adibhudapratama/BARELANG/cargo_hold_v6/docs/interior.jpg

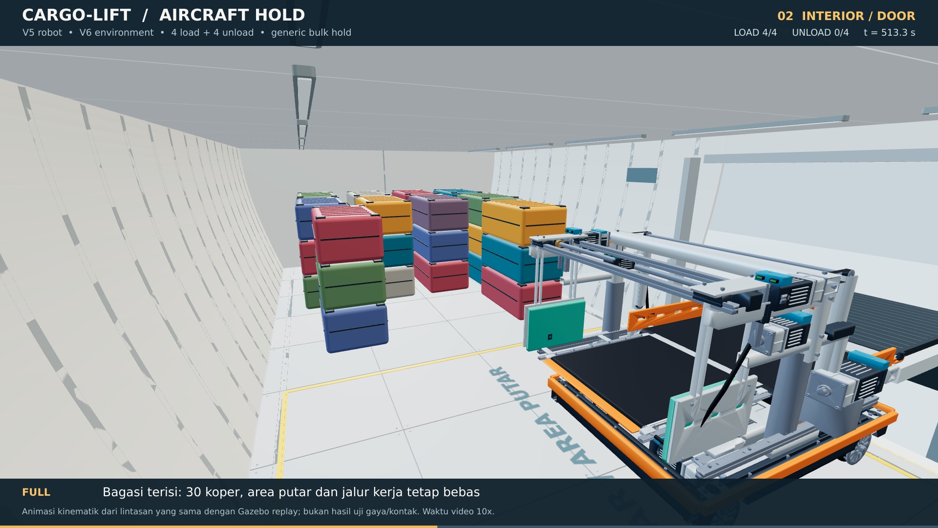
cargo_hold_v6/docs/interior.jpg
