adibhudapratama/BARELANG/cargo_hold_v6/docs/Storyboard_v6.jpg

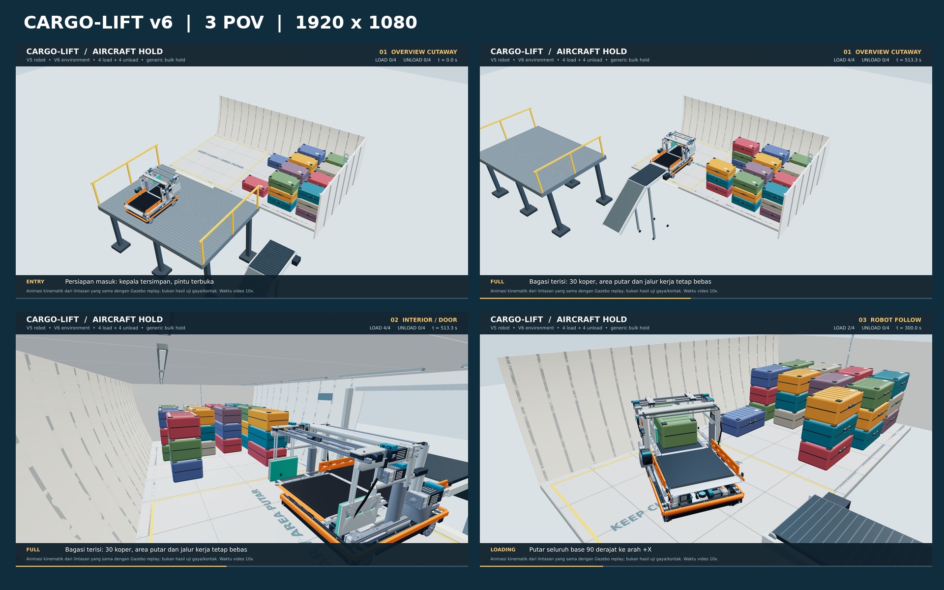
cargo_hold_v6/docs/Storyboard_v6.jpg
