adibhudapratama/BARELANG/cargo_hold_v6/docs/tracking.jpg

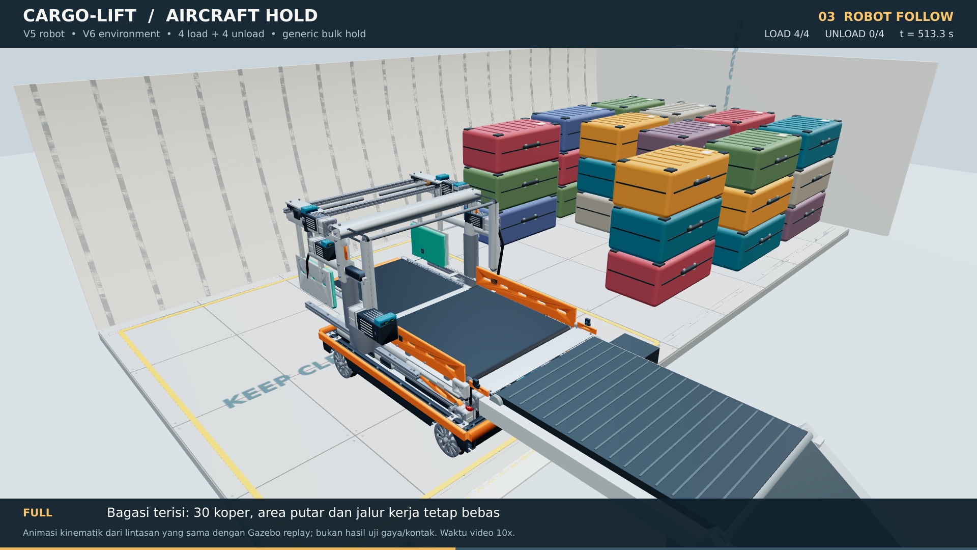
cargo_hold_v6/docs/tracking.jpg
