adibhudapratama/BARELANG/cargo_hold_v6/cad/Bagasi_Pesawat_Generic_Full.step

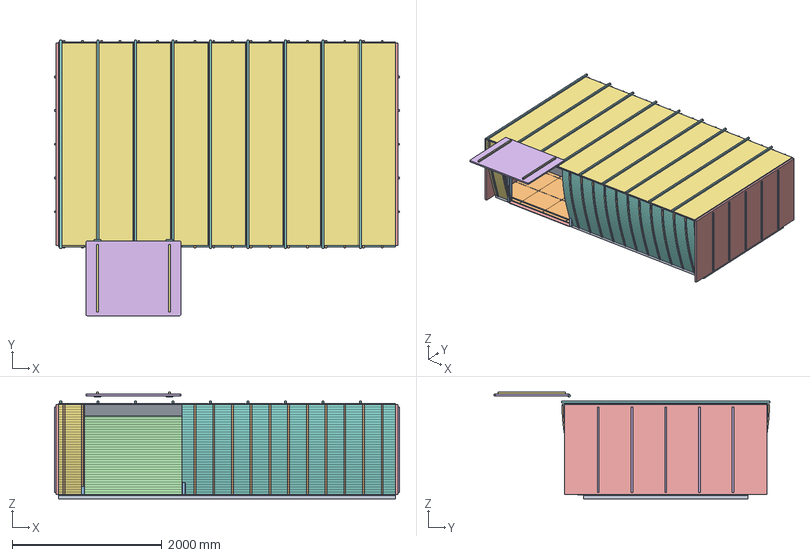
[picture p19: CAD file, 2026-10-20]
cargo_hold_v6/cad/Bagasi_Pesawat_Generic_Full.step
4606.0 x 3680.0 x 1424.5 mm
