adibhudapratama/BARELANG/cargo_hold_v6/models/cargo_robot/meshes/main_belt_roller_link__00.stl

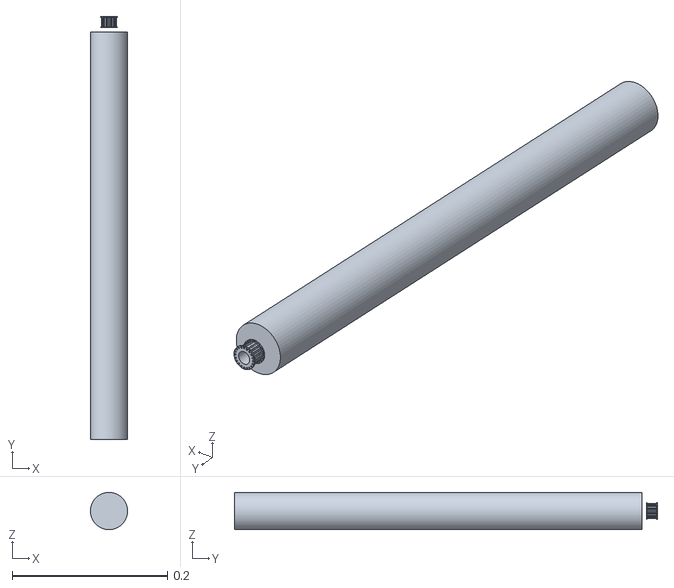
[picture p20: CAD file, 2026-10-20]
cargo_hold_v6/models/cargo_robot/meshes/main_belt_roller_link__00.stl
0.048 x 0.545 x 0.048
