adibhudapratama/BARELANG/cargo_hold_v6/models/cargo_robot/meshes/main_belt_roller_link.stl

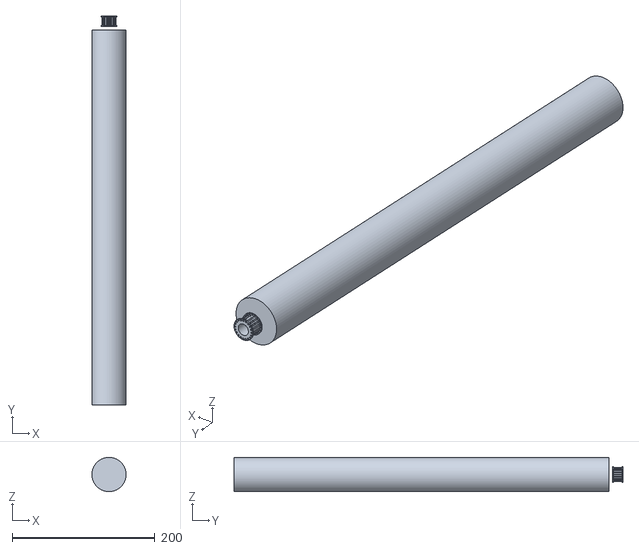
[picture p21: CAD file, 2026-10-20]
cargo_hold_v6/models/cargo_robot/meshes/main_belt_roller_link.stl
47.9 x 544.7 x 48.0
