adibhudapratama/BARELANG/cargo_hold_v6/models/aircraft_hold/meshes/door_1.stl

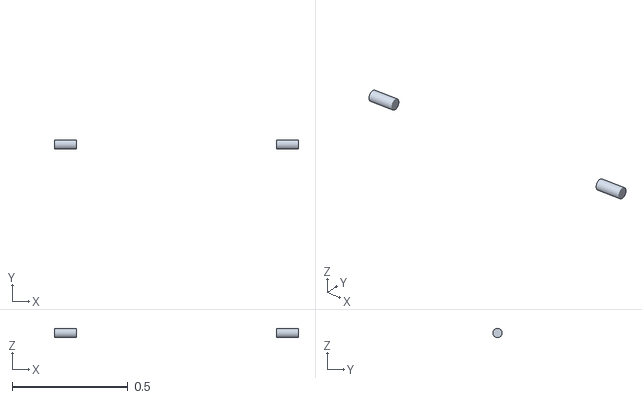
[picture p22: CAD file, 2026-10-20]
cargo_hold_v6/models/aircraft_hold/meshes/door_1.stl
1.06 x 0.04 x 0.04
