adibhudapratama/BARELANG/cargo_hold_v6/models/cargo_robot/meshes/rr_roller11_link__01.stl

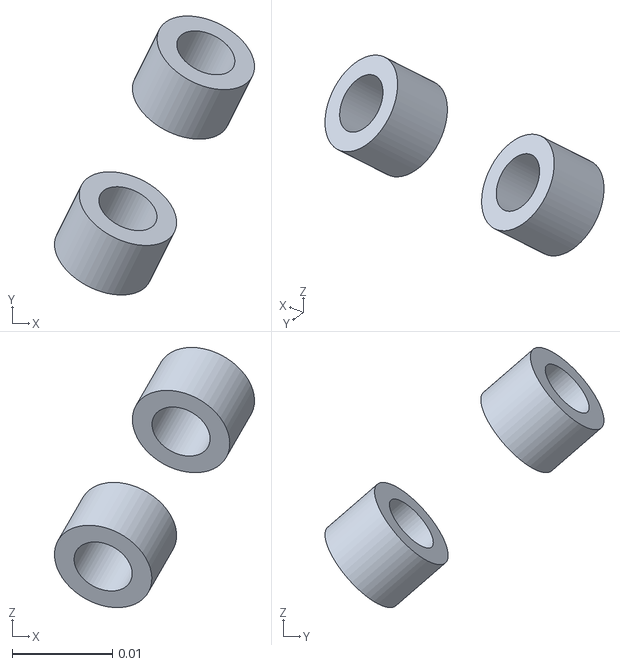
[picture p23: CAD file, 2026-10-20]
cargo_hold_v6/models/cargo_robot/meshes/rr_roller11_link__01.stl
0.02 x 0.0279 x 0.026
