adibhudapratama/BARELANG/cargo_hold_v6/models/luggage/meshes/trim.stl

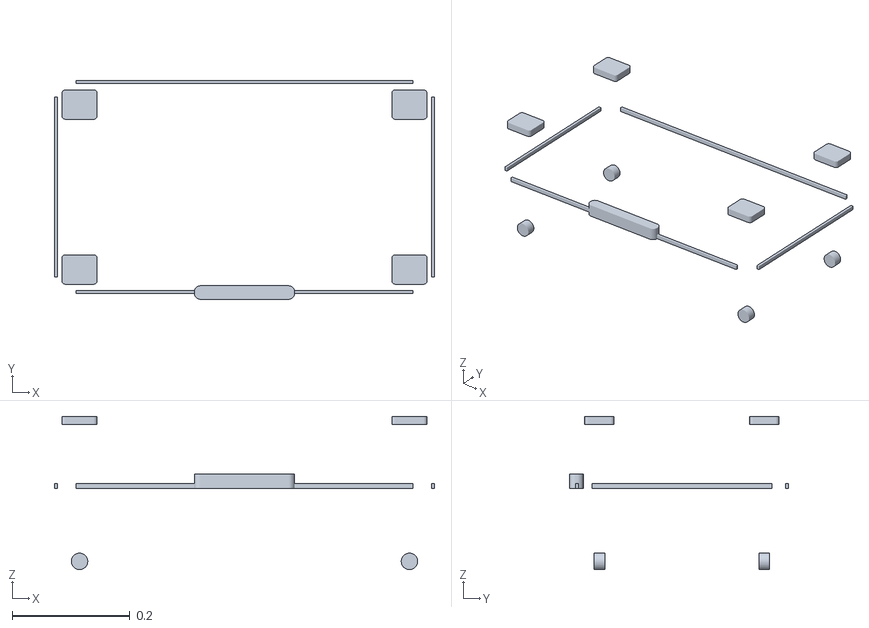
[picture p24: CAD file, 2026-10-20]
cargo_hold_v6/models/luggage/meshes/trim.stl
0.645 x 0.371 x 0.26
