adibhudapratama/BARELANG/cargo_hold_v6/ros2_ws/src/cargo_robot_description/models/cargo_robot/meshes/fr_roller02_link__00.stl

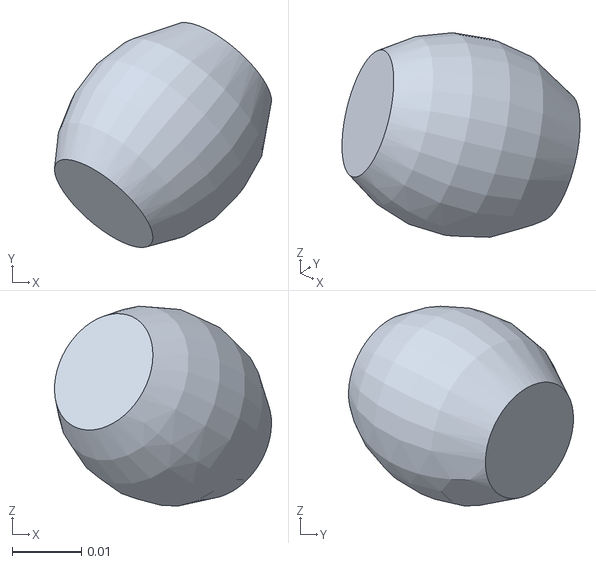
[picture p25: CAD file, 2026-10-20]
cargo_hold_v6/ros2_ws/src/cargo_robot_description/models/cargo_robot/meshes/fr_roller02_link__00.stl
0.0314 x 0.0325 x 0.0289
