adibhudapratama/BARELANG/cargo_hold_v6/cad/Bagasi_Pesawat_Generic_Cutaway.step

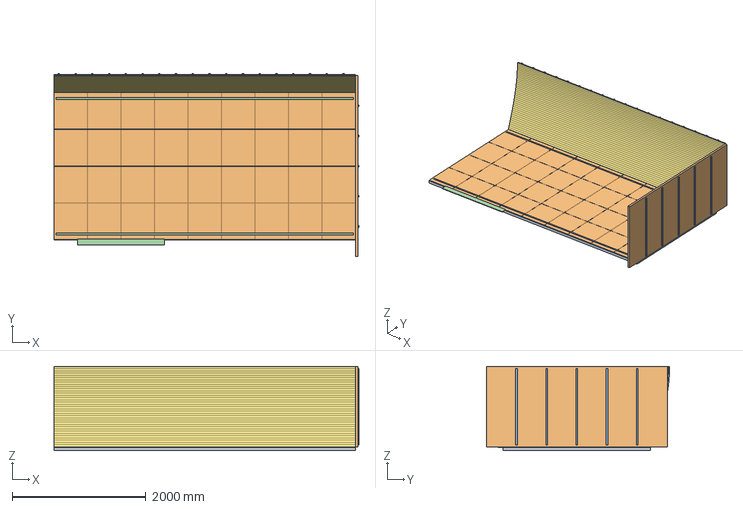
[picture p26: CAD file, 2026-10-20]
cargo_hold_v6/cad/Bagasi_Pesawat_Generic_Cutaway.step
4553.0 x 2735.0 x 1257.0 mm
