adibhudapratama/BARELANG/cargo_hold_v6/models/aircraft_hold/meshes/near_wall_0.stl

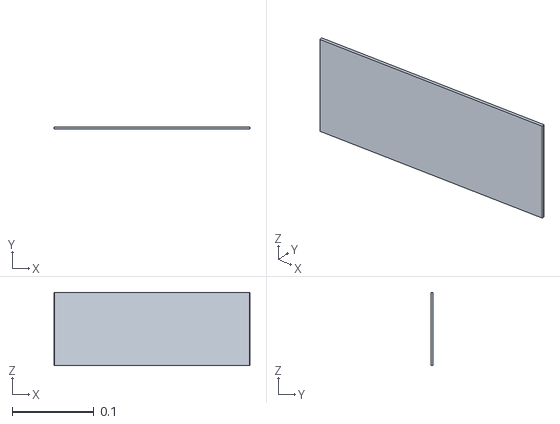
[picture p27: CAD file, 2026-10-20]
cargo_hold_v6/models/aircraft_hold/meshes/near_wall_0.stl
0.24 x 0.003 x 0.09
