adibhudapratama/BARELANG/cargo_hold_v6/models/cargo_robot/meshes/fl_roller10_link__02.stl

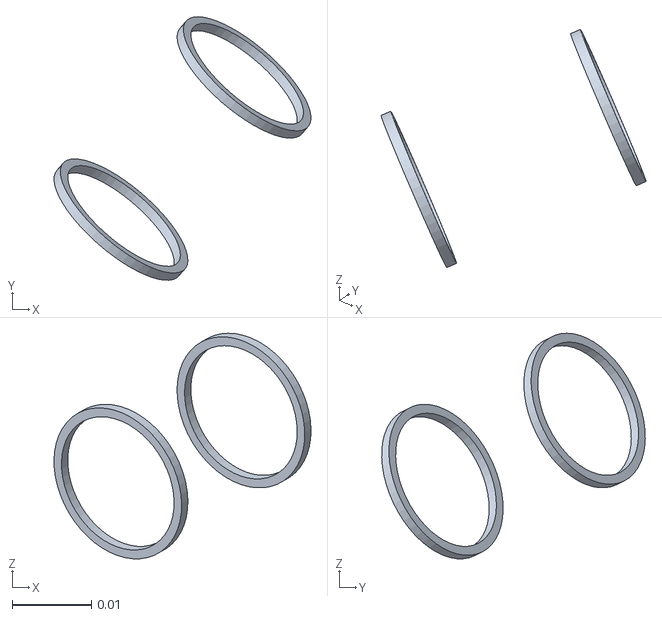
[picture p28: CAD file, 2026-10-20]
cargo_hold_v6/models/cargo_robot/meshes/fl_roller10_link__02.stl
0.0325 x 0.0333 x 0.0285
