adibhudapratama/BARELANG/cargo_hold_v6/models/luggage/meshes/shell.stl

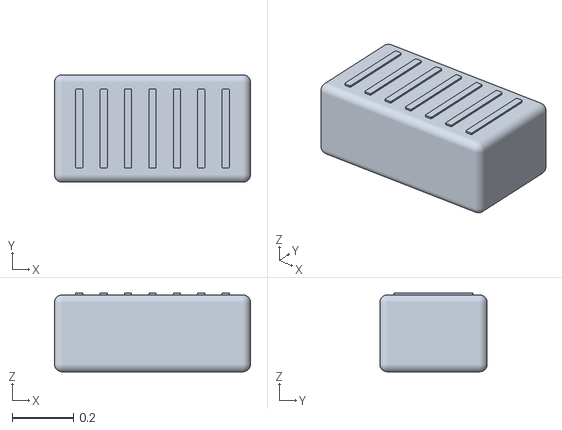
[picture p29: CAD file, 2026-10-20]
cargo_hold_v6/models/luggage/meshes/shell.stl
0.642 x 0.352 x 0.258
