adibhudapratama/BARELANG/cargo_hold_v6/models/aircraft_hold/meshes/near_wall_4.stl

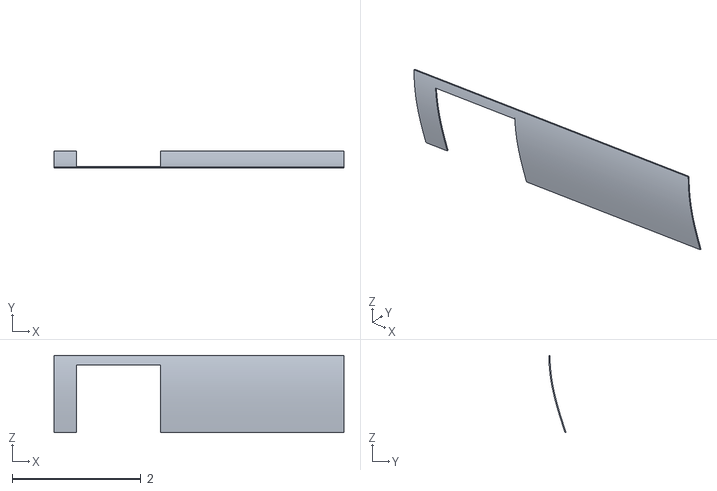
[picture p30: CAD file, 2026-10-20]
cargo_hold_v6/models/aircraft_hold/meshes/near_wall_4.stl
4.50 x 0.268 x 1.20
