adibhudapratama/BARELANG/cargo_hold_v6/ros2_ws/src/cargo_robot_description/models/cargo_robot/meshes/rr_roller06_link__02.stl

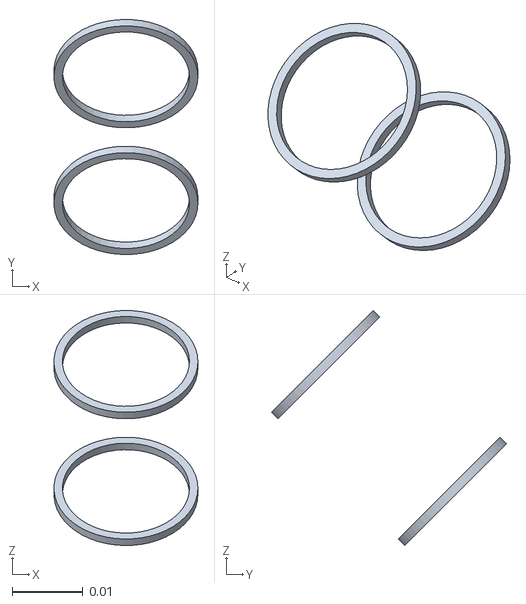
[picture p31: CAD file, 2026-10-20]
cargo_hold_v6/ros2_ws/src/cargo_robot_description/models/cargo_robot/meshes/rr_roller06_link__02.stl
0.0204 x 0.0333 x 0.0333
