adibhudapratama/BARELANG/cad/Cargo_Lift_Robot.step

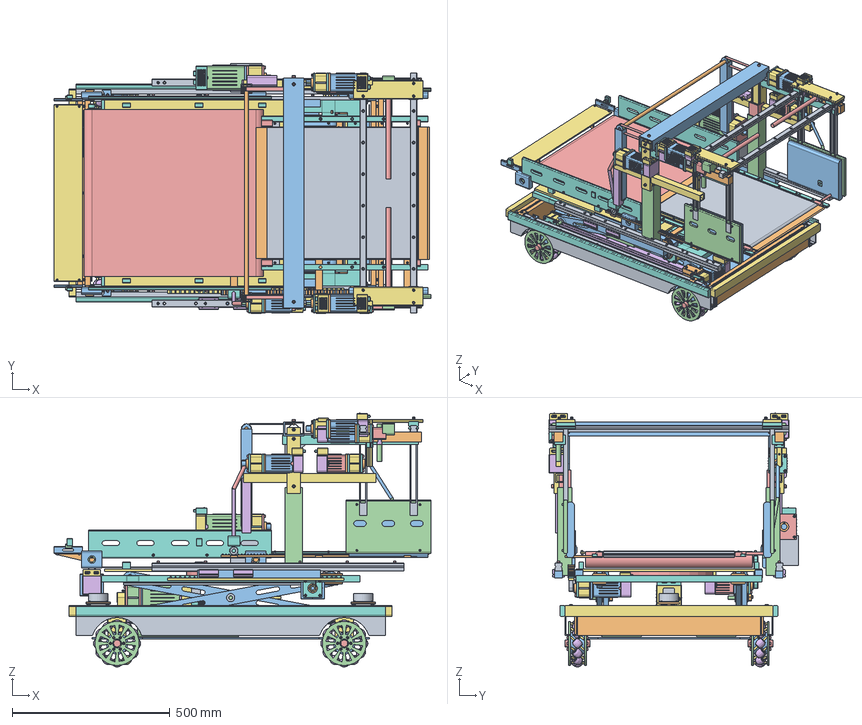
[picture p32: CAD file, 2026-10-20]
cad/Cargo_Lift_Robot.step
1195.0 x 791.0 x 804.4 mm
