adibhudapratama/BARELANG/cargo_hold_v6/models/aircraft_hold/meshes/floor_6.stl

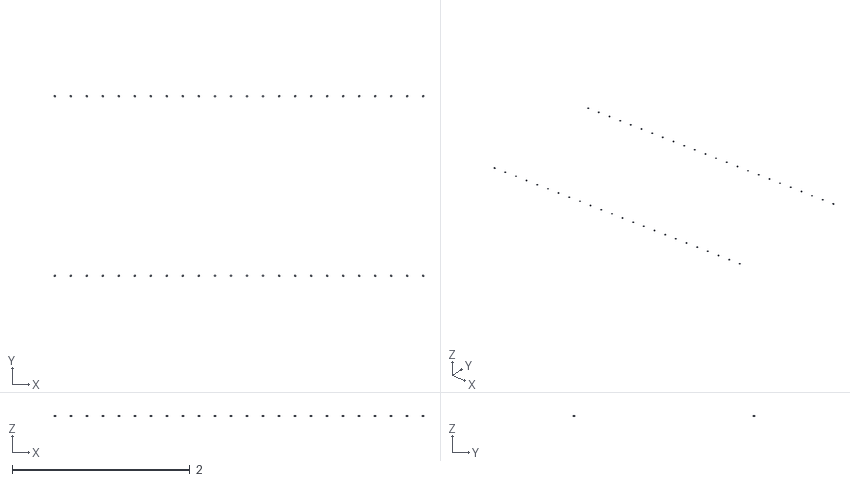
[picture p33: CAD file, 2026-10-20]
cargo_hold_v6/models/aircraft_hold/meshes/floor_6.stl
4.16 x 2.04 x 0.002
