adibhudapratama/BARELANG/cargo_hold_v6/models/cargo_robot/meshes/lift_carrier_link__01.stl

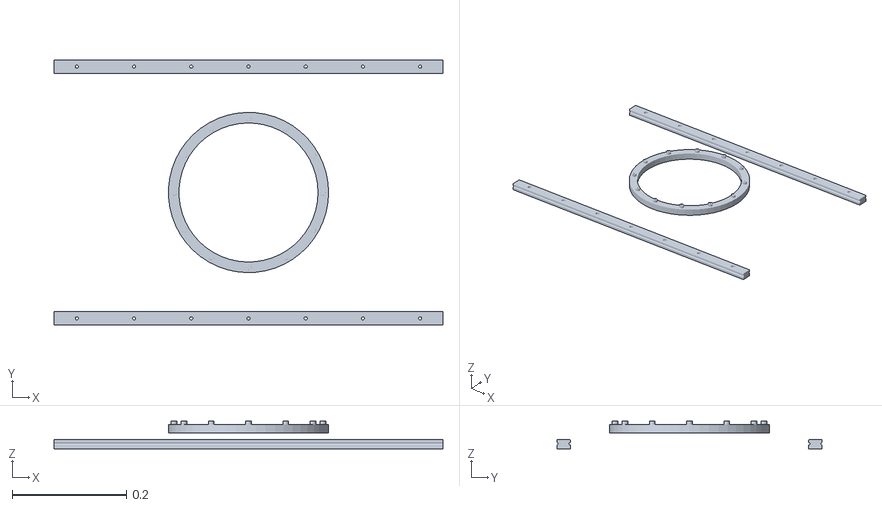
[picture p34: CAD file, 2026-10-20]
cargo_hold_v6/models/cargo_robot/meshes/lift_carrier_link__01.stl
0.68 x 0.464 x 0.0485
