adibhudapratama/BARELANG/cargo_hold_v6/ros2_ws/src/cargo_robot_description/models/cargo_robot/meshes/support_blade_link__01.stl

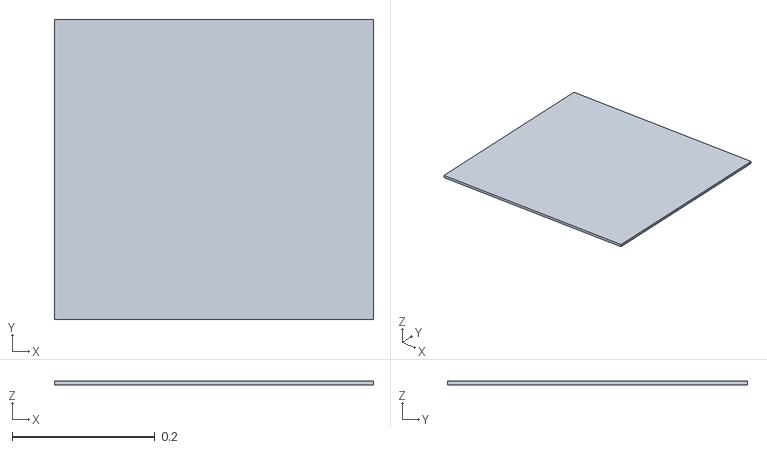
[picture p35: CAD file, 2026-10-20]
cargo_hold_v6/ros2_ws/src/cargo_robot_description/models/cargo_robot/meshes/support_blade_link__01.stl
0.447 x 0.42 x 0.005
