adibhudapratama/BARELANG/cargo_hold_v6/models/aircraft_hold/meshes/door_0.stl

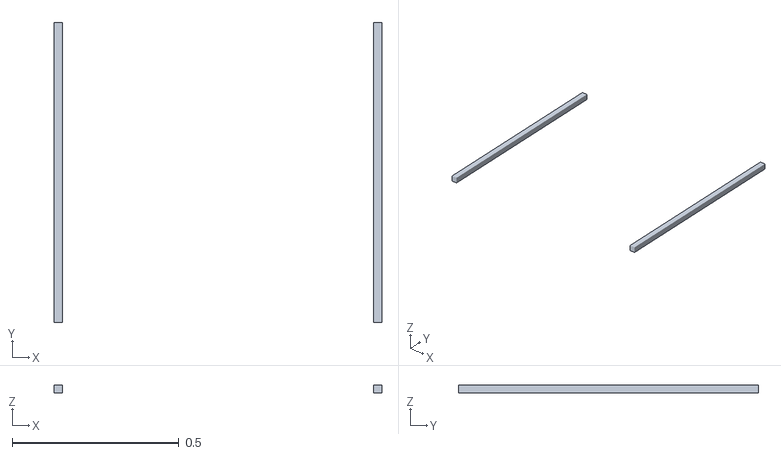
[picture p37: CAD file, 2026-10-20]
cargo_hold_v6/models/aircraft_hold/meshes/door_0.stl
0.985 x 0.9 x 0.025
