adibhudapratama/BARELANG/cargo_hold_v6/models/cargo_robot/meshes/fr_roller06_link__00.stl

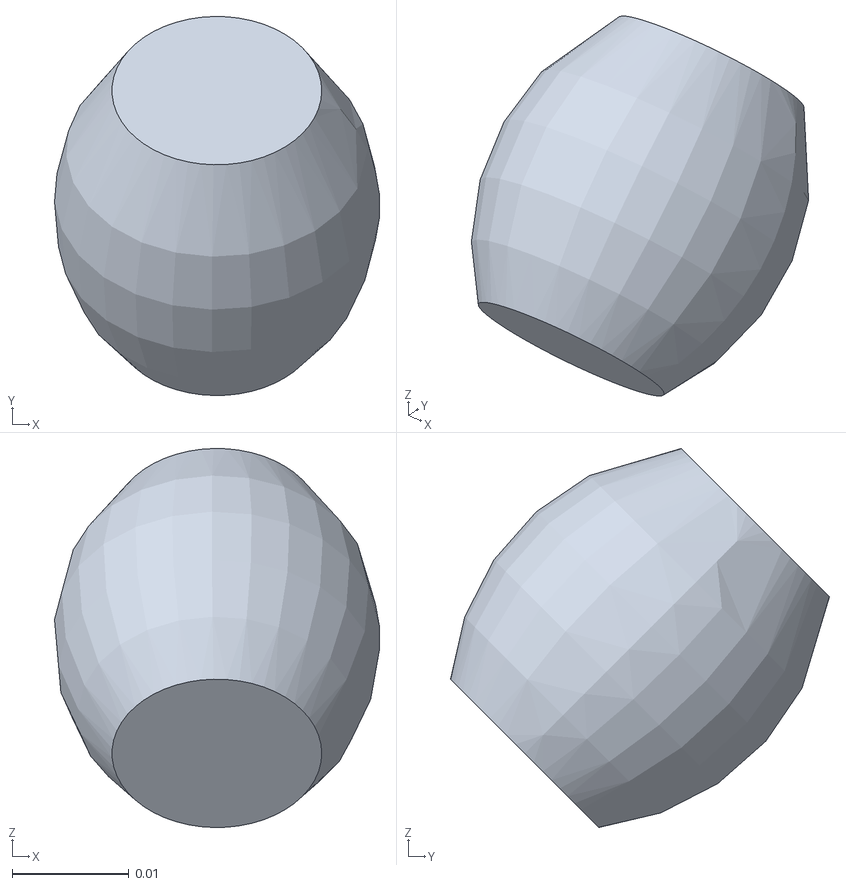
[picture p38: CAD file, 2026-10-20]
cargo_hold_v6/models/cargo_robot/meshes/fr_roller06_link__00.stl
0.0279 x 0.0325 x 0.0325
