adibhudapratama/BARELANG/cargo_hold_v6/models/aircraft_hold/meshes/roof_2.stl

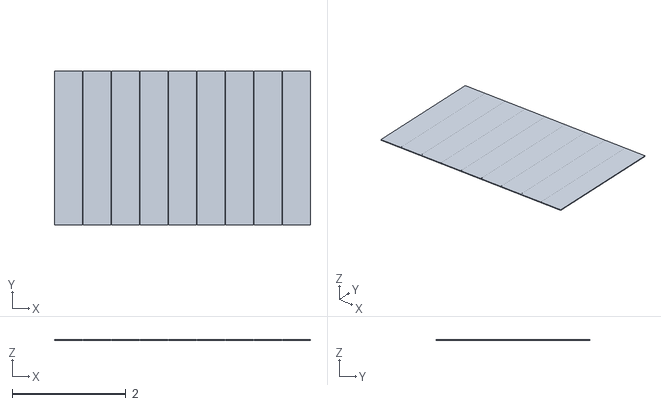
[picture p39: CAD file, 2026-10-20]
cargo_hold_v6/models/aircraft_hold/meshes/roof_2.stl
4.50 x 2.70 x 0.014
