adibhudapratama/BARELANG/cargo_hold_v6/models/cargo_robot/meshes/extension_link.stl

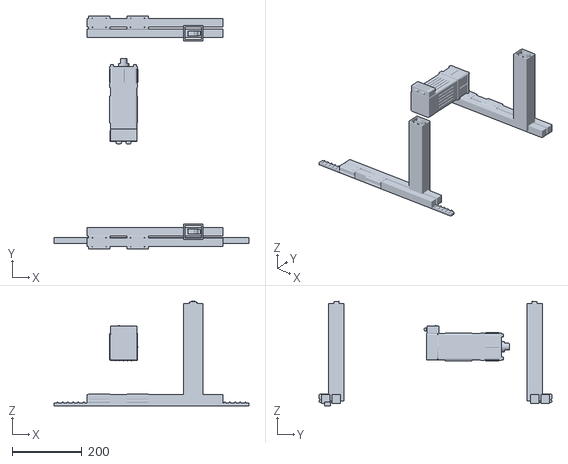
[picture p40: CAD file, 2026-10-20]
cargo_hold_v6/models/cargo_robot/meshes/extension_link.stl
560.0 x 668.0 x 301.5
