adibhudapratama/BARELANG/cargo_hold_v6/models/aircraft_hold/meshes/roof_0.stl

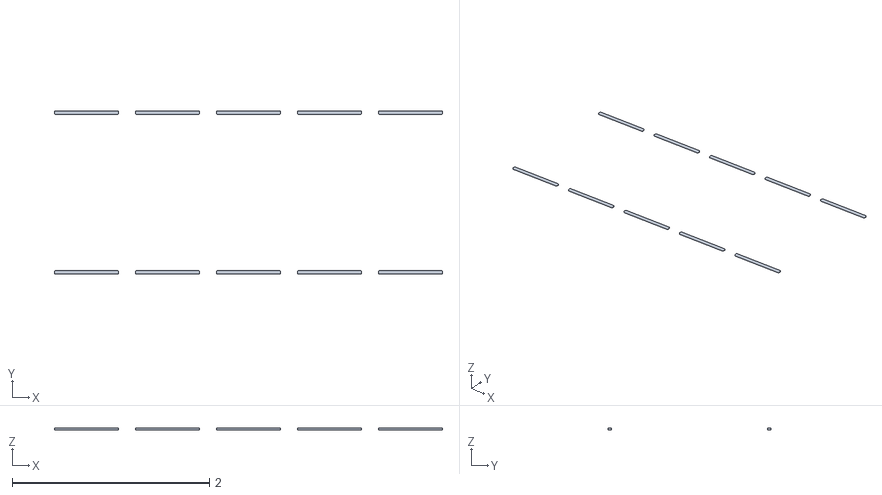
[picture p41: CAD file, 2026-10-20]
cargo_hold_v6/models/aircraft_hold/meshes/roof_0.stl
3.93 x 1.66 x 0.016
