adibhudapratama/BARELANG/cargo_hold_v6/models/cargo_robot/meshes/rl_roller01_link.stl

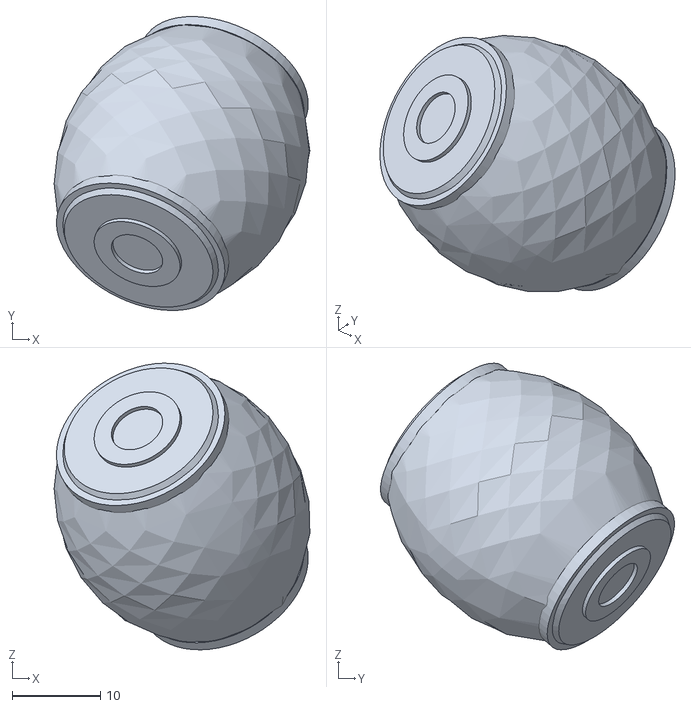
[picture p42: CAD file, 2026-10-20]
cargo_hold_v6/models/cargo_robot/meshes/rl_roller01_link.stl
29.0 x 33.3 x 32.5
