adibhudapratama/BARELANG/cargo_hold_v6/ros2_ws/src/cargo_robot_description/models/cargo_robot/meshes/fl_roller00_link__01.stl

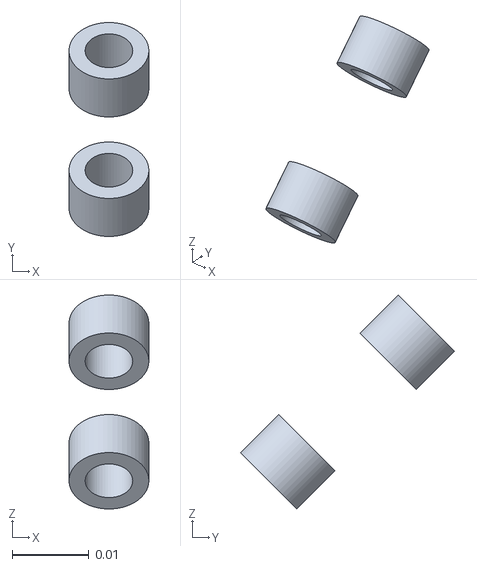
[picture p43: CAD file, 2026-10-20]
cargo_hold_v6/ros2_ws/src/cargo_robot_description/models/cargo_robot/meshes/fl_roller00_link__01.stl
0.0104 x 0.0279 x 0.0279
