adibhudapratama/BARELANG/cargo_hold_v6/models/aircraft_hold/meshes/floor_7.stl

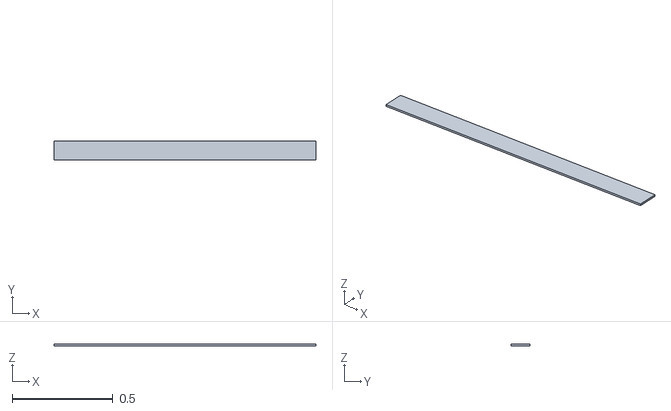
[picture p44: CAD file, 2026-10-20]
cargo_hold_v6/models/aircraft_hold/meshes/floor_7.stl
1.30 x 0.095 x 0.008
