adibhudapratama/BARELANG/cargo_hold_v6/models/cargo_robot/meshes/conveyor_yaw_link__07.stl

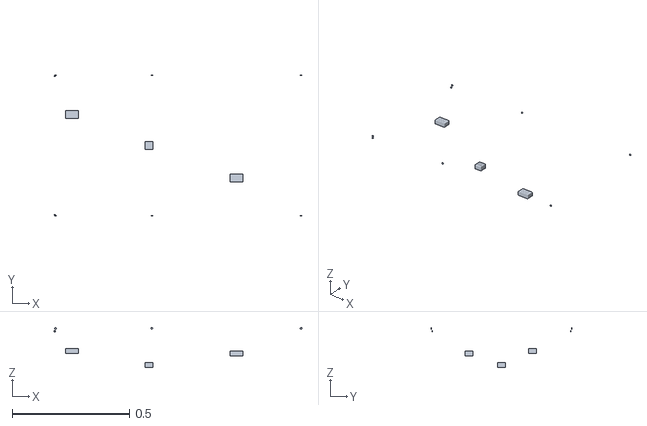
[picture p45: CAD file, 2026-10-20]
cargo_hold_v6/models/cargo_robot/meshes/conveyor_yaw_link__07.stl
1.06 x 0.599 x 0.171
