adibhudapratama/BARELANG/cargo_hold_v6/models/aircraft_hold/meshes/front_wall_0.stl

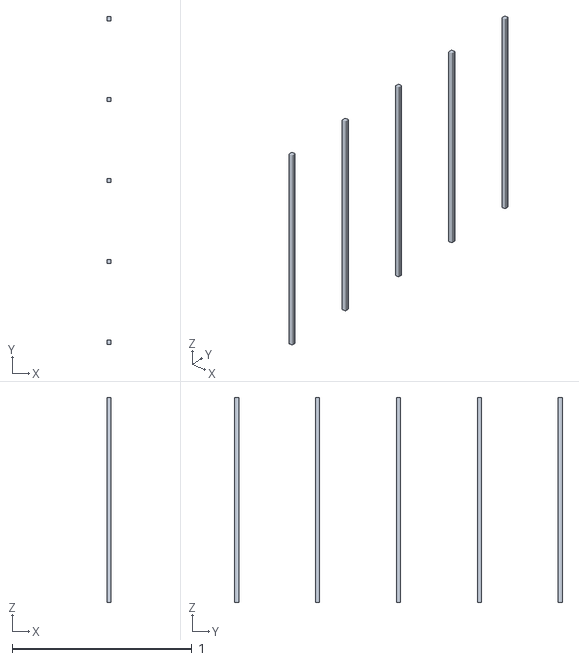
[picture p46: CAD file, 2026-10-20]
cargo_hold_v6/models/aircraft_hold/meshes/front_wall_0.stl
0.022 x 1.82 x 1.14
