adibhudapratama/BARELANG/cargo_hold_v6/ros2_ws/src/cargo_robot_description/models/cargo_robot/meshes/conveyor_yaw_link__00.stl

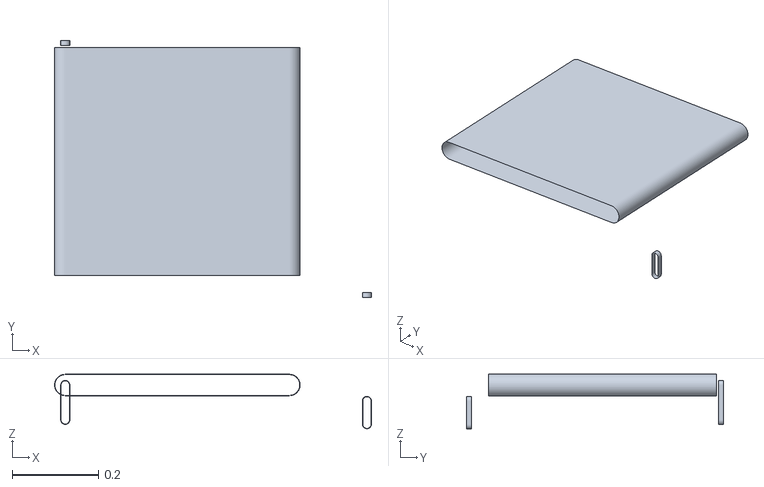
[picture p47: CAD file, 2026-10-20]
cargo_hold_v6/ros2_ws/src/cargo_robot_description/models/cargo_robot/meshes/conveyor_yaw_link__00.stl
0.736 x 0.597 x 0.127
