adibhudapratama/BARELANG/cargo_hold_v6/models/cargo_robot/meshes/pickup_head_link__05.stl

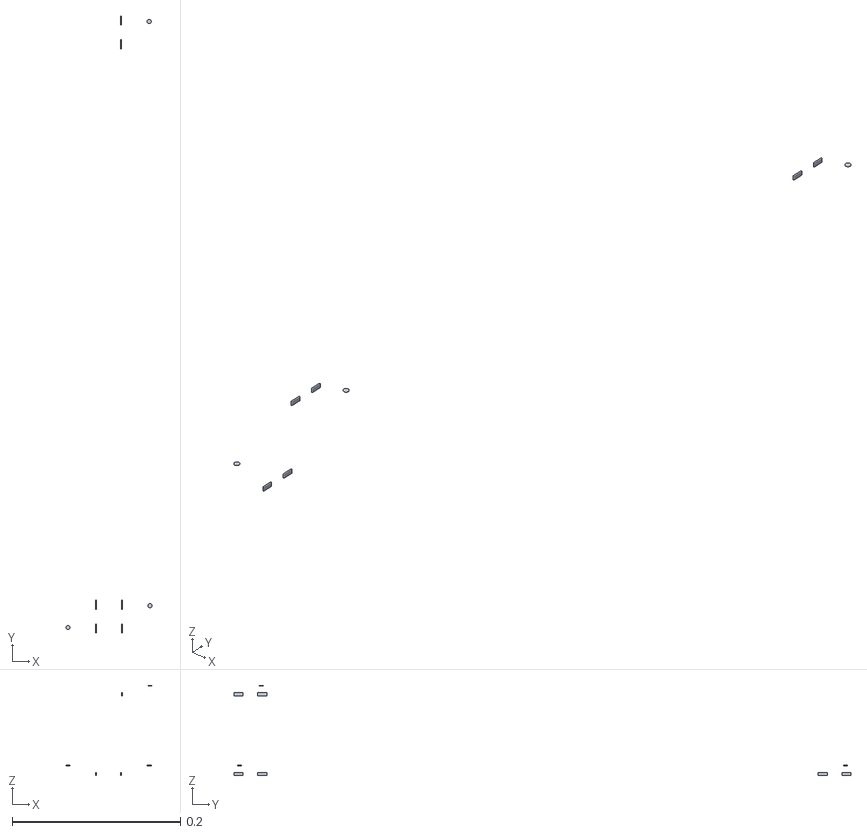
[picture p49: CAD file, 2026-10-20]
cargo_hold_v6/models/cargo_robot/meshes/pickup_head_link__05.stl
0.103 x 0.734 x 0.108
