adibhudapratama/BARELANG/cargo_hold_v6/models/aircraft_hold/meshes/floor_3.stl

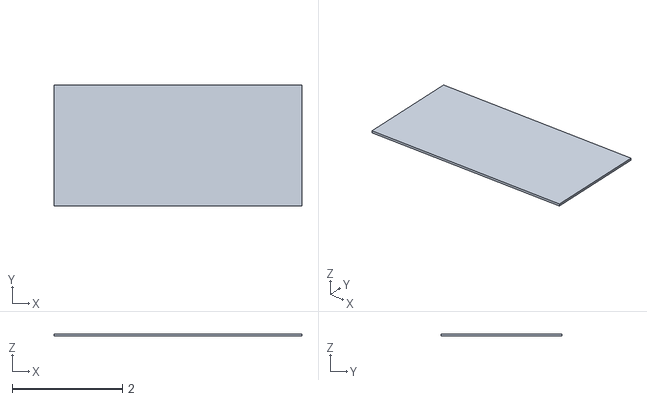
[picture p50: CAD file, 2026-10-20]
cargo_hold_v6/models/aircraft_hold/meshes/floor_3.stl
4.50 x 2.20 x 0.045
