adibhudapratama/BARELANG/cargo_hold_v6/ros2_ws/src/cargo_robot_description/models/cargo_robot/meshes/fl_wheel_link__00.stl

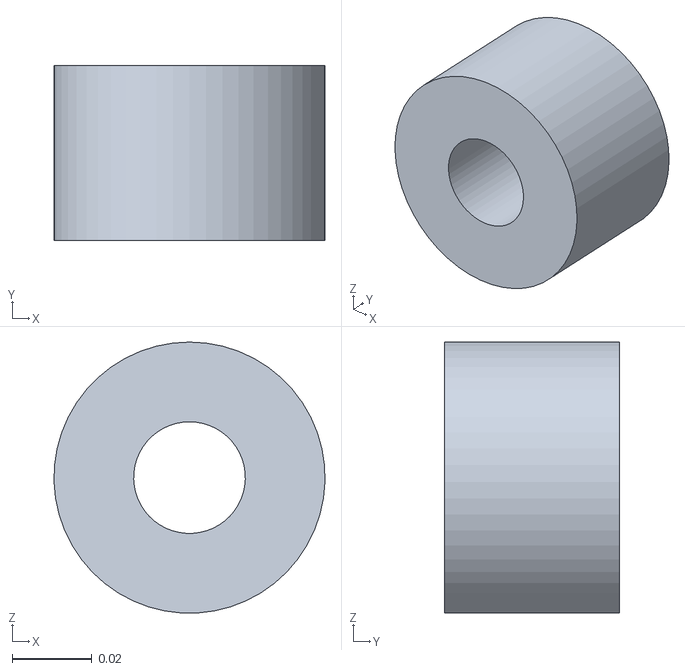
[picture p51: CAD file, 2026-10-20]
cargo_hold_v6/ros2_ws/src/cargo_robot_description/models/cargo_robot/meshes/fl_wheel_link__00.stl
0.068 x 0.044 x 0.0679
