adibhudapratama/BARELANG/cargo_hold_v6/models/aircraft_hold/meshes/far_wall_2.stl

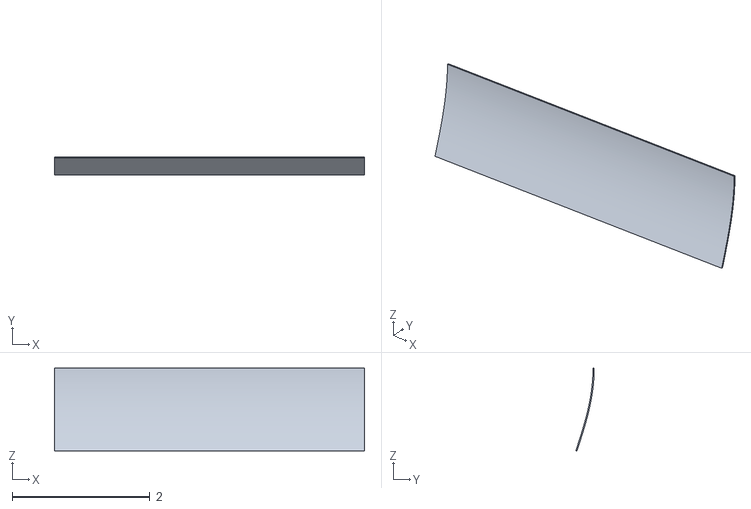
[picture p52: CAD file, 2026-10-20]
cargo_hold_v6/models/aircraft_hold/meshes/far_wall_2.stl
4.50 x 0.268 x 1.20
