adibhudapratama/BARELANG/cargo_hold_v6/models/cargo_robot/meshes/conveyor_yaw_link__04.stl

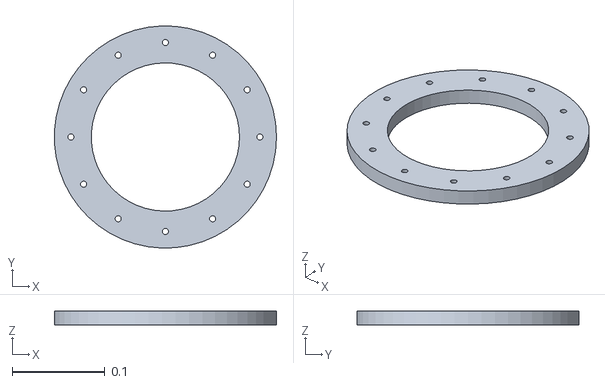
[picture p53: CAD file, 2026-10-20]
cargo_hold_v6/models/cargo_robot/meshes/conveyor_yaw_link__04.stl
0.24 x 0.24 x 0.015
