adibhudapratama/BARELANG/cargo_hold_v6/models/aircraft_hold/meshes/floor_0.stl

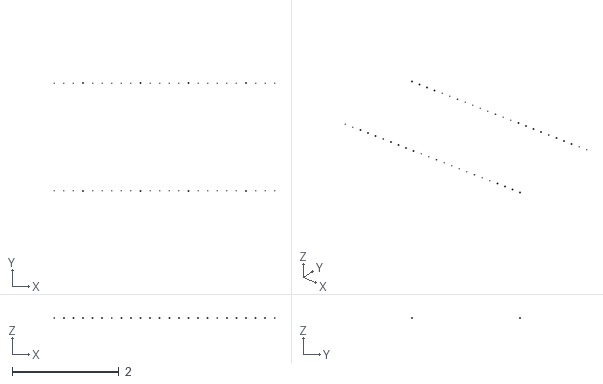
[picture p54: CAD file, 2026-10-20]
cargo_hold_v6/models/aircraft_hold/meshes/floor_0.stl
4.15 x 2.03 x 0.0022
