adibhudapratama/BARELANG/cargo_hold_v6/ros2_ws/src/cargo_robot_description/models/cargo_robot/meshes/lower_slider_link__02.stl

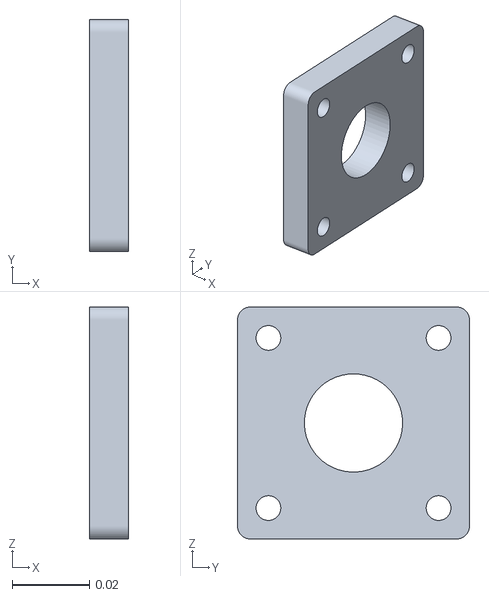
[picture p55: CAD file, 2026-10-20]
cargo_hold_v6/ros2_ws/src/cargo_robot_description/models/cargo_robot/meshes/lower_slider_link__02.stl
0.01 x 0.06 x 0.06
