adibhudapratama/BARELANG/cargo_hold_v6/models/aircraft_hold/meshes/near_wall_1.stl

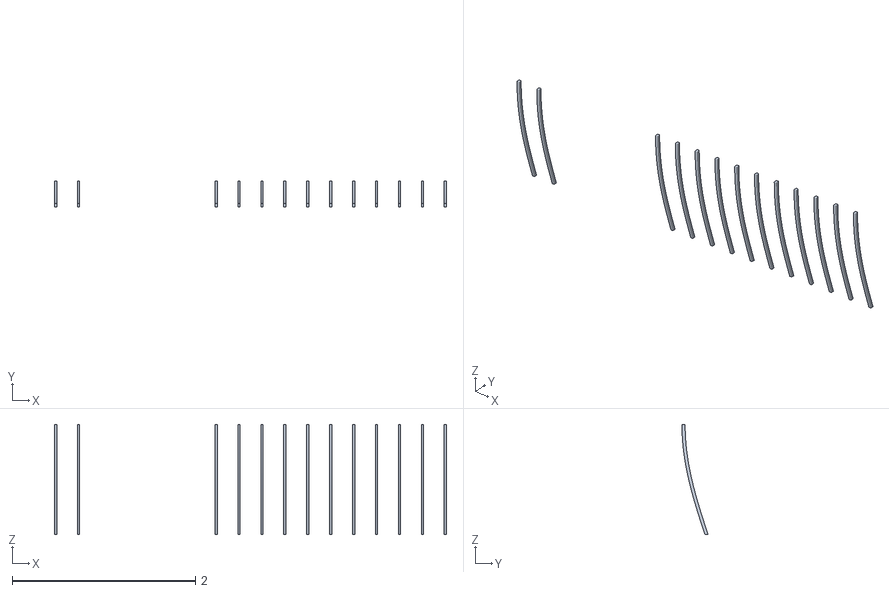
[picture p56: CAD file, 2026-10-20]
cargo_hold_v6/models/aircraft_hold/meshes/near_wall_1.stl
4.28 x 0.285 x 1.20
