adibhudapratama/BARELANG/cargo_hold_v6/ros2_ws/src/cargo_robot_description/models/cargo_robot/meshes/pickup_head_link__01.stl

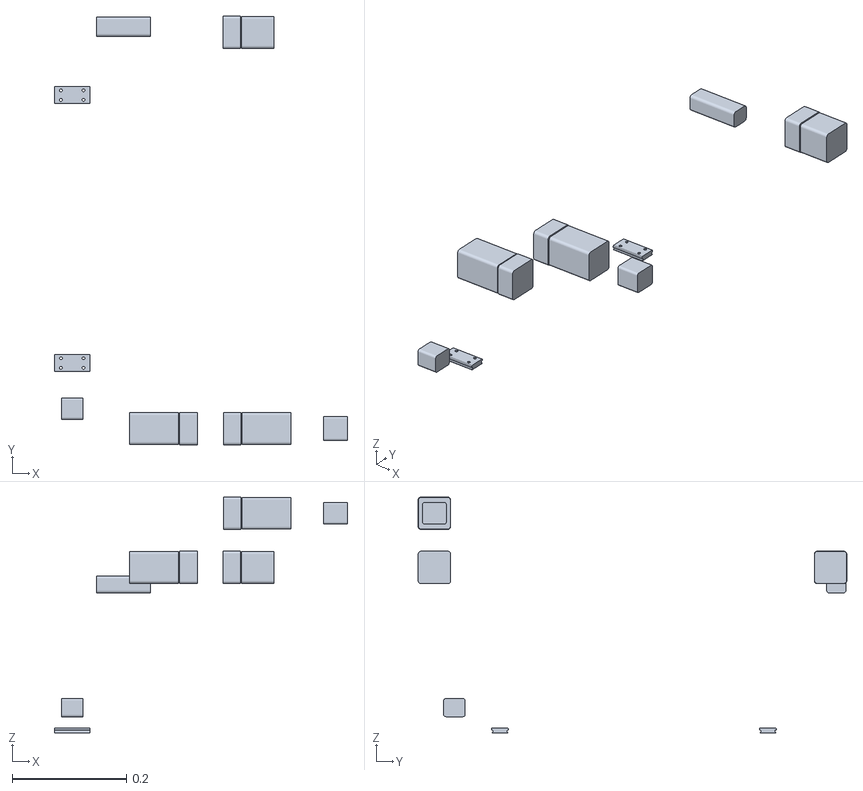
[picture p57: CAD file, 2026-10-20]
cargo_hold_v6/ros2_ws/src/cargo_robot_description/models/cargo_robot/meshes/pickup_head_link__01.stl
0.514 x 0.752 x 0.414
