adibhudapratama/BARELANG/cargo_hold_v6/models/aircraft_hold/meshes/near_wall_2.stl

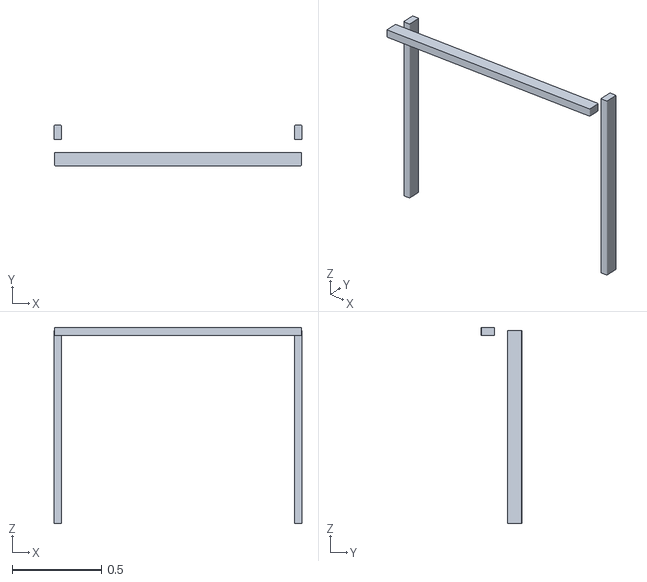
[picture p58: CAD file, 2026-10-20]
cargo_hold_v6/models/aircraft_hold/meshes/near_wall_2.stl
1.39 x 0.227 x 1.10
