adibhudapratama/BARELANG/cargo_hold_v6/models/aircraft_hold/meshes/near_wall_3.stl

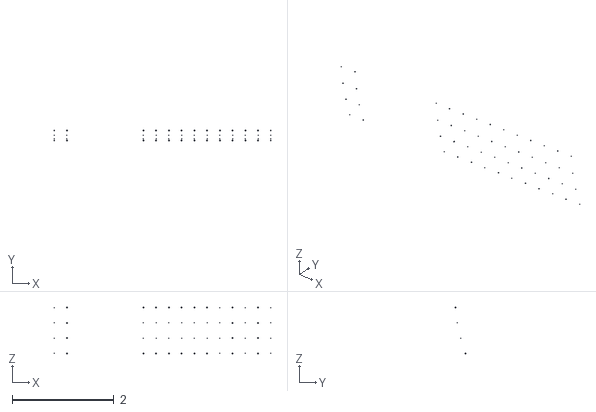
[picture p59: CAD file, 2026-10-20]
cargo_hold_v6/models/aircraft_hold/meshes/near_wall_3.stl
4.26 x 0.204 x 0.908
