adibhudapratama/BARELANG/cargo_hold_v6/ros2_ws/src/cargo_robot_description/models/cargo_robot/meshes/right_up_arm_link__00.stl

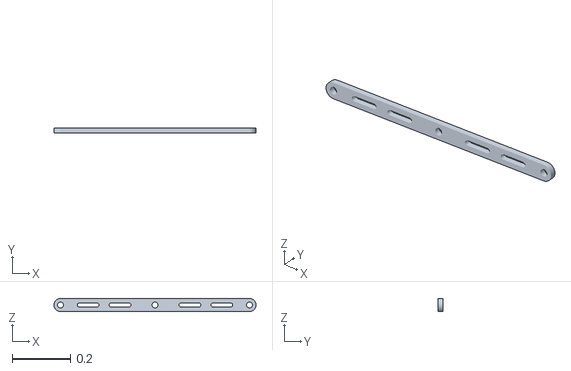
[picture p60: CAD file, 2026-10-20]
cargo_hold_v6/ros2_ws/src/cargo_robot_description/models/cargo_robot/meshes/right_up_arm_link__00.stl
0.695 x 0.016 x 0.045
