adibhudapratama/BARELANG/cargo_hold_v6/models/aircraft_hold/meshes/rear_wall_1.stl

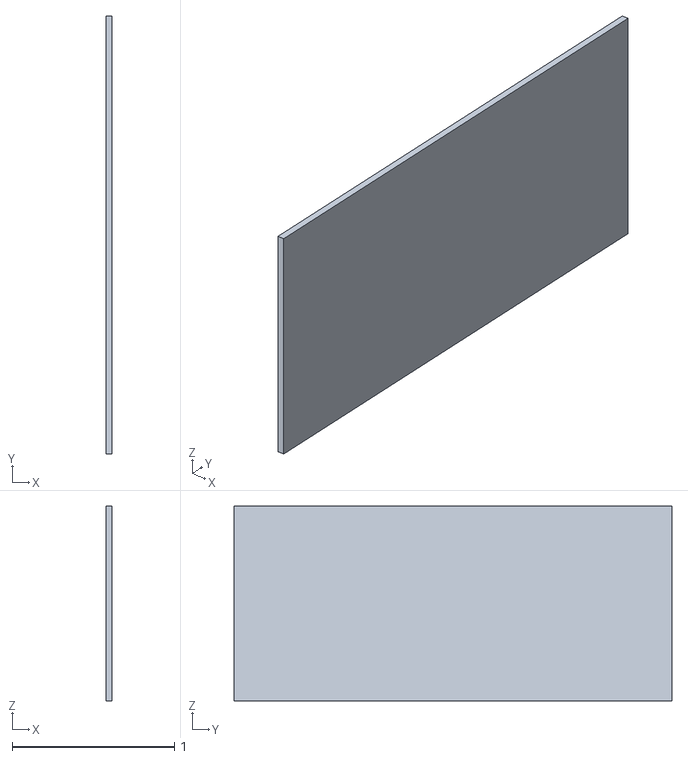
[picture p61: CAD file, 2026-10-20]
cargo_hold_v6/models/aircraft_hold/meshes/rear_wall_1.stl
0.036 x 2.70 x 1.20
