adibhudapratama/BARELANG/cargo_hold_v6/models/cargo_robot/meshes/base_link__03.stl

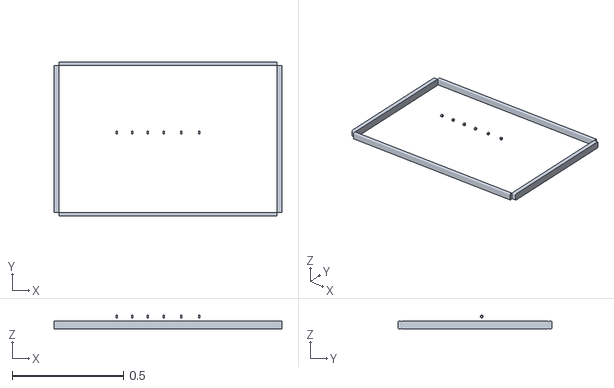
[picture p62: CAD file, 2026-10-20]
cargo_hold_v6/models/cargo_robot/meshes/base_link__03.stl
1.02 x 0.692 x 0.062
