adibhudapratama/BARELANG/cargo_hold_v6/models/aircraft_hold/meshes/roof_1.stl

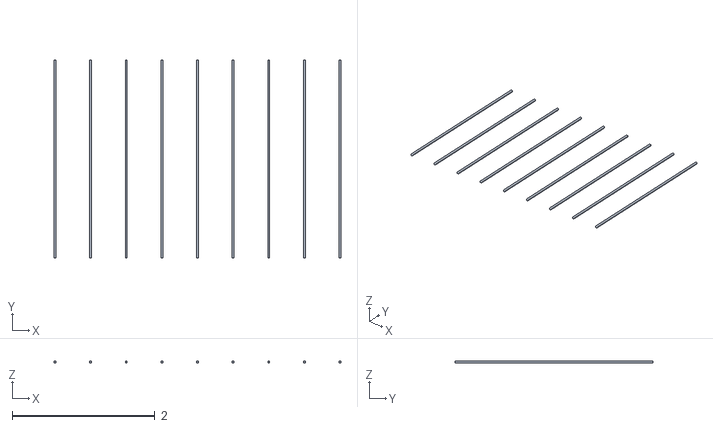
[picture p63: CAD file, 2026-10-20]
cargo_hold_v6/models/aircraft_hold/meshes/roof_1.stl
4.03 x 2.78 x 0.028
