adibhudapratama/BARELANG/cargo_hold_v6/models/aircraft_hold/meshes/floor_5.stl

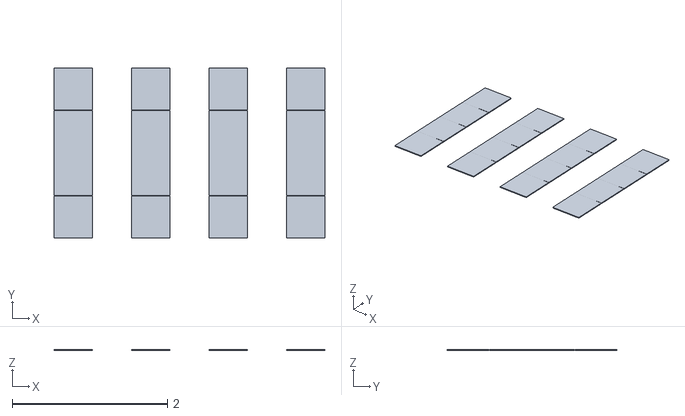
[picture p64: CAD file, 2026-10-20]
cargo_hold_v6/models/aircraft_hold/meshes/floor_5.stl
3.50 x 2.20 x 0.012
