adibhudapratama/BARELANG/cargo_hold_v6/models/cargo_robot/meshes/extension_link__06.stl

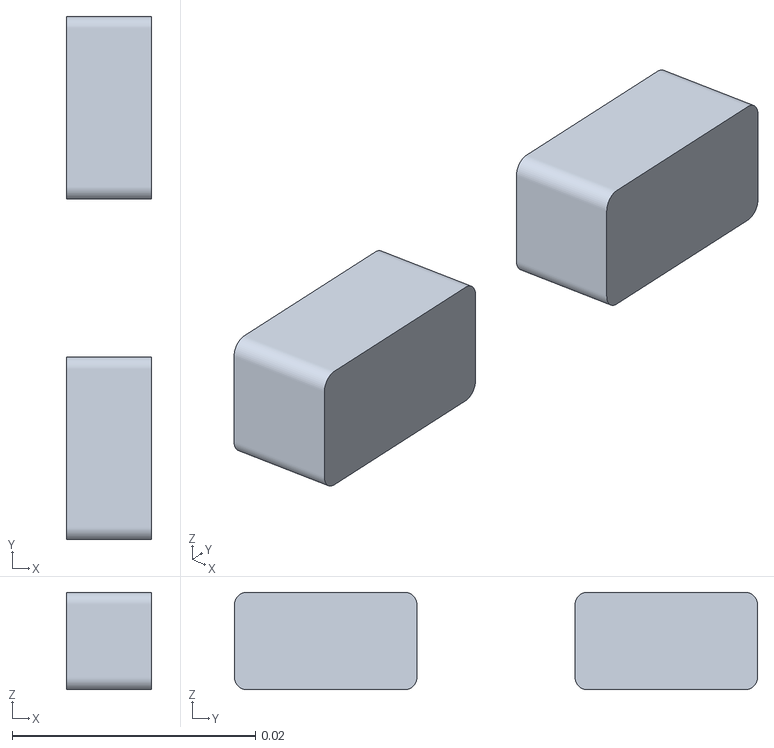
[picture p65: CAD file, 2026-10-20]
cargo_hold_v6/models/cargo_robot/meshes/extension_link__06.stl
0.007 x 0.043 x 0.008
