adibhudapratama/BARELANG/cargo_hold_v6/models/aircraft_hold/meshes/far_wall_0.stl

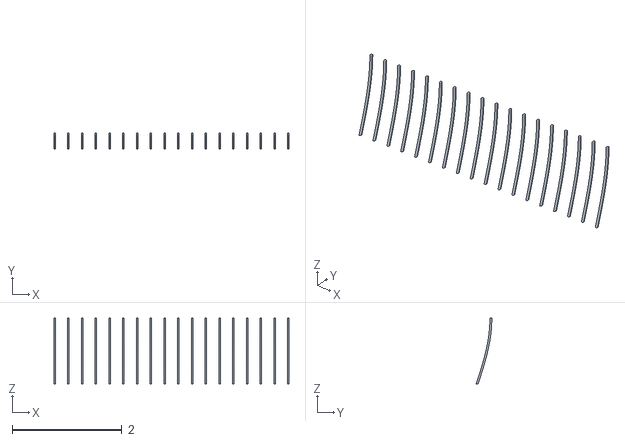
[picture p67: CAD file, 2026-10-20]
cargo_hold_v6/models/aircraft_hold/meshes/far_wall_0.stl
4.28 x 0.285 x 1.20
