adibhudapratama/BARELANG/cargo_hold_v6/models/aircraft_hold/meshes/roof_3.stl

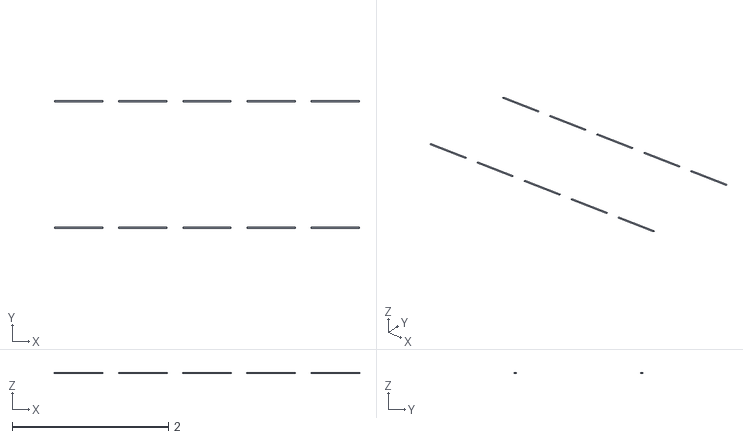
[picture p68: CAD file, 2026-10-20]
cargo_hold_v6/models/aircraft_hold/meshes/roof_3.stl
3.90 x 1.64 x 0.004
