adibhudapratama/BARELANG/cargo_hold_v6/ros2_ws/src/cargo_robot_description/models/cargo_robot/meshes/jaw_frame_link__01.stl

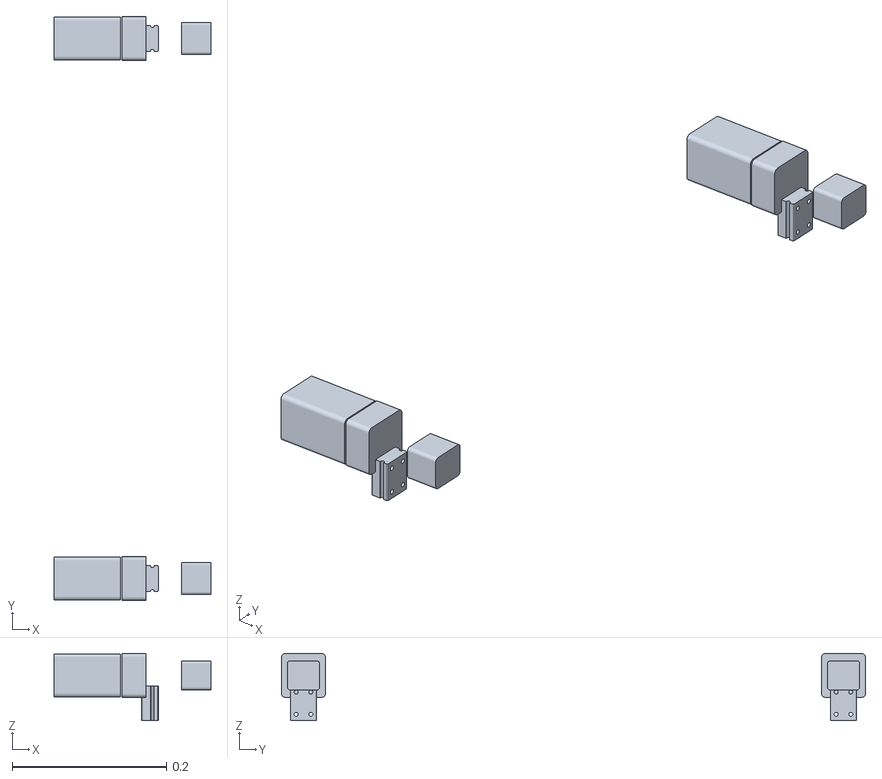
[picture p69: CAD file, 2026-10-20]
cargo_hold_v6/ros2_ws/src/cargo_robot_description/models/cargo_robot/meshes/jaw_frame_link__01.stl
0.203 x 0.757 x 0.087
