adibhudapratama/BARELANG/cargo_hold_v6/models/aircraft_hold/meshes/door_2.stl

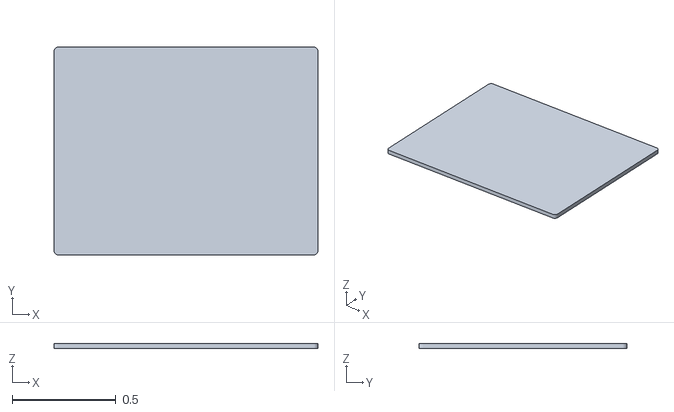
[picture p71: CAD file, 2026-10-20]
cargo_hold_v6/models/aircraft_hold/meshes/door_2.stl
1.27 x 1.00 x 0.025
