adibhudapratama/BARELANG/cargo_hold_v6/models/aircraft_hold/meshes/floor_8.stl

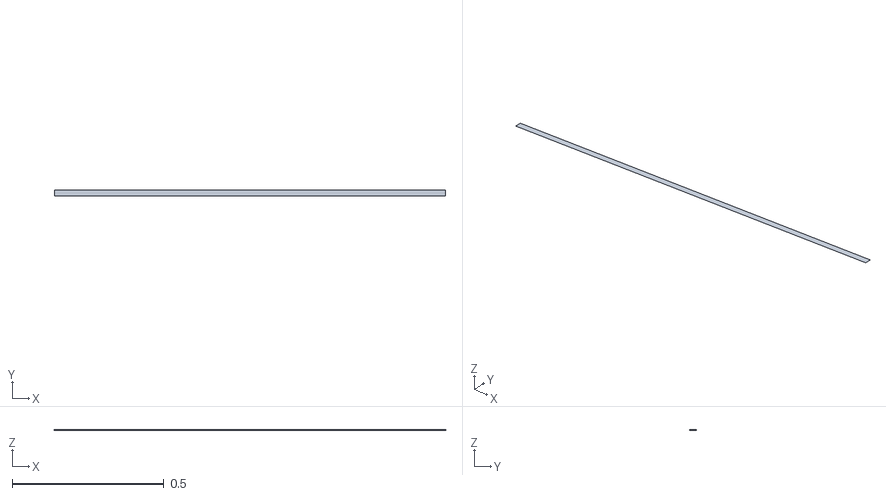
[picture p72: CAD file, 2026-10-20]
cargo_hold_v6/models/aircraft_hold/meshes/floor_8.stl
1.29 x 0.02 x 0.001
