adibhudapratama/BARELANG/cargo_hold_v6/models/aircraft_hold/meshes/floor_2.stl

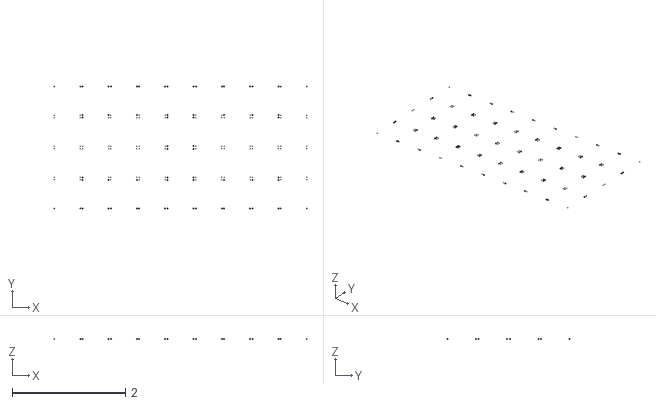
[picture p73: CAD file, 2026-10-20]
cargo_hold_v6/models/aircraft_hold/meshes/floor_2.stl
4.47 x 2.16 x 0.0015
