adibhudapratama/BARELANG/cargo_hold_v6/models/aircraft_hold/meshes/floor_1.stl

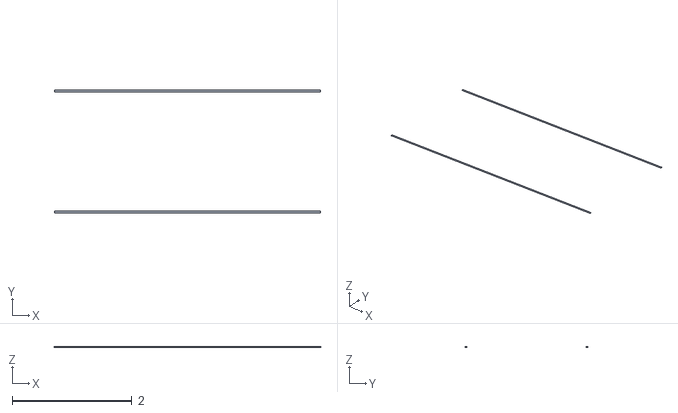
[picture p75: CAD file, 2026-10-20]
cargo_hold_v6/models/aircraft_hold/meshes/floor_1.stl
4.44 x 2.05 x 0.004
