adibhudapratama/BARELANG/cargo_hold_v6/ros2_ws/src/cargo_robot_description/models/cargo_robot/meshes/head_stage2_link__01.stl

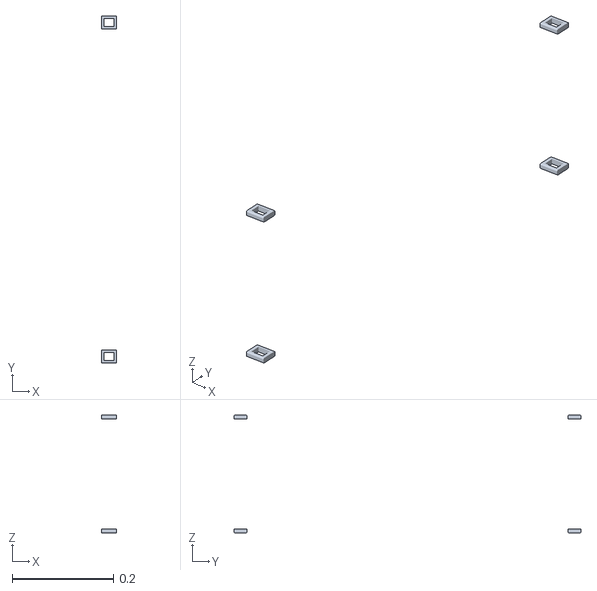
[picture p76: CAD file, 2026-10-20]
cargo_hold_v6/ros2_ws/src/cargo_robot_description/models/cargo_robot/meshes/head_stage2_link__01.stl
0.03 x 0.686 x 0.233
