adibhudapratama/BARELANG/cargo_hold_v6/models/cargo_robot/meshes/head_stage1_link.stl

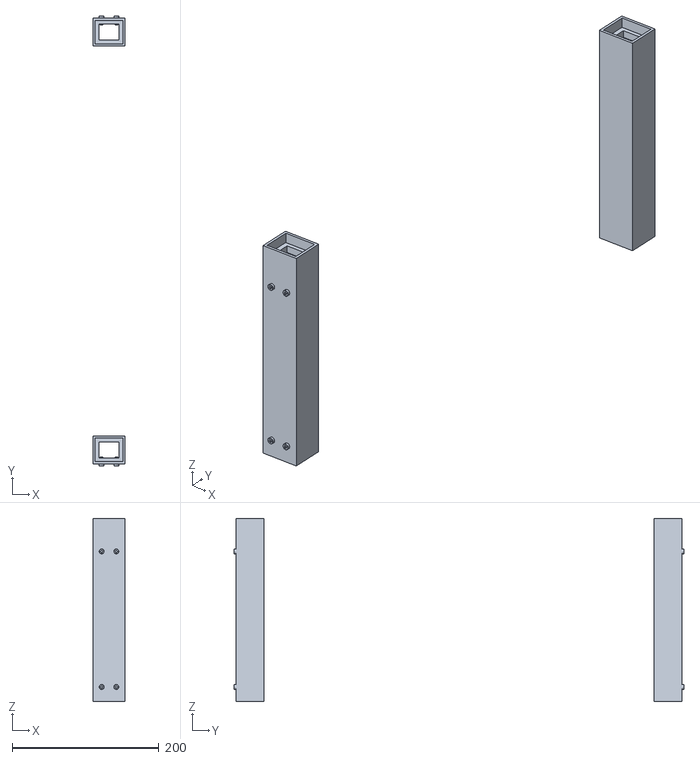
[picture p77: CAD file, 2026-10-20]
cargo_hold_v6/models/cargo_robot/meshes/head_stage1_link.stl
44.0 x 614.0 x 250.0
