adibhudapratama/BARELANG/cargo_hold_v6/models/cargo_robot/meshes/lift_carrier_link__00.stl

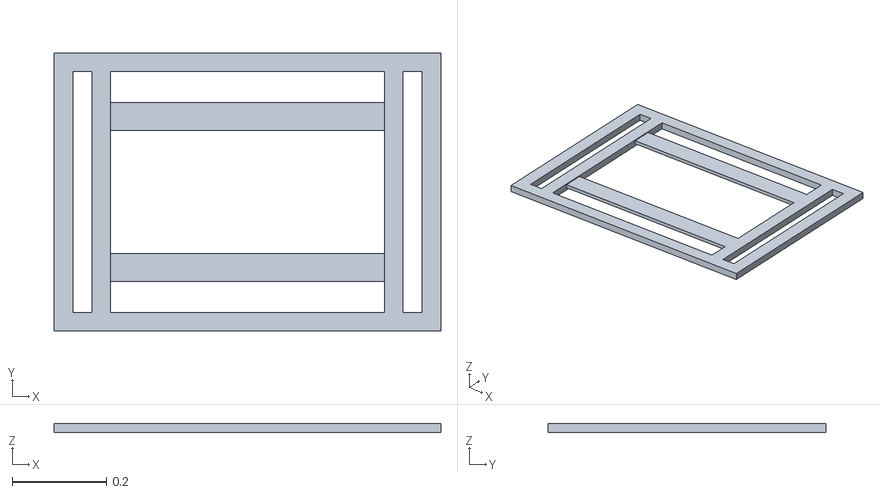
[picture p79: CAD file, 2026-10-20]
cargo_hold_v6/models/cargo_robot/meshes/lift_carrier_link__00.stl
0.82 x 0.59 x 0.02
