adibhudapratama/BARELANG/cargo_hold_v6/models/cargo_robot/meshes/support_blade_link__03.stl

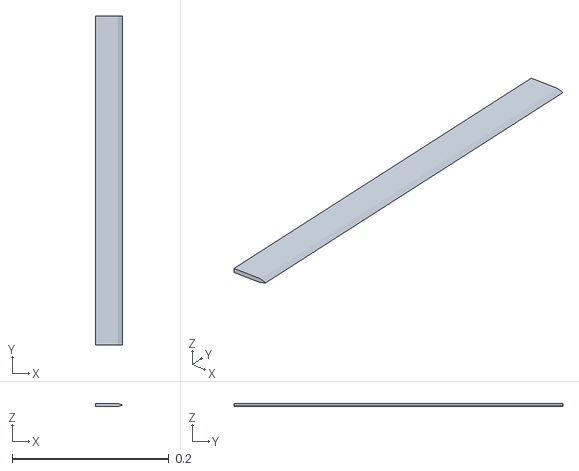
[picture p80: CAD file, 2026-10-20]
cargo_hold_v6/models/cargo_robot/meshes/support_blade_link__03.stl
0.035 x 0.42 x 0.004
