adibhudapratama/BARELANG/cargo_hold_v6/ros2_ws/src/cargo_robot_description/models/cargo_robot/meshes/conveyor_yaw_link__03.stl

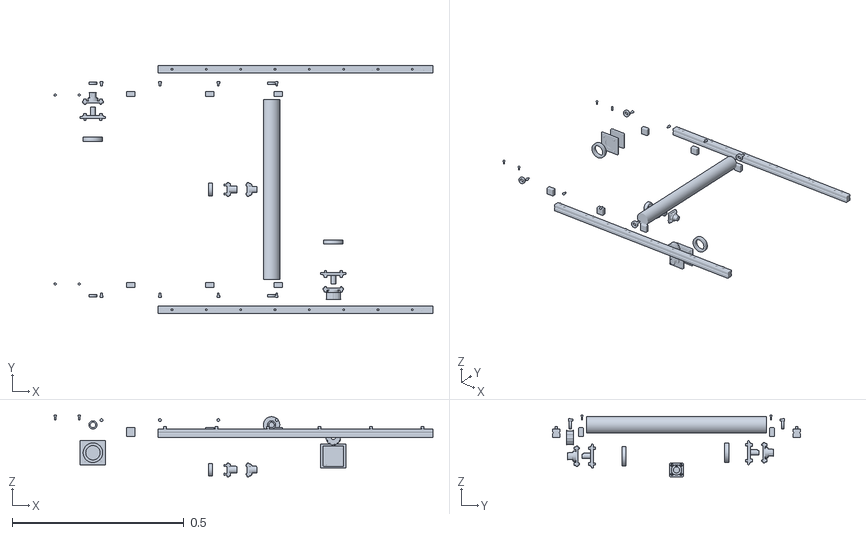
[picture p81: CAD file, 2026-10-20]
cargo_hold_v6/ros2_ws/src/cargo_robot_description/models/cargo_robot/meshes/conveyor_yaw_link__03.stl
1.10 x 0.722 x 0.179
