adibhudapratama/BARELANG/cargo_hold_v6/ros2_ws/src/cargo_robot_description/models/cargo_robot/meshes/left_up_arm_link__02.stl

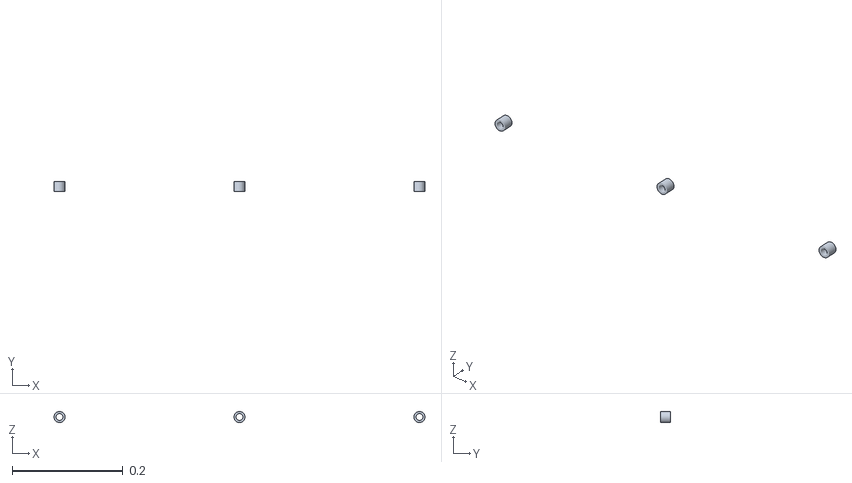
[picture p82: CAD file, 2026-10-20]
cargo_hold_v6/ros2_ws/src/cargo_robot_description/models/cargo_robot/meshes/left_up_arm_link__02.stl
0.67 x 0.018 x 0.02
