adibhudapratama/BARELANG/cargo_hold_v6/ros2_ws/src/cargo_robot_description/models/cargo_robot/meshes/pickup_head_link__00.stl

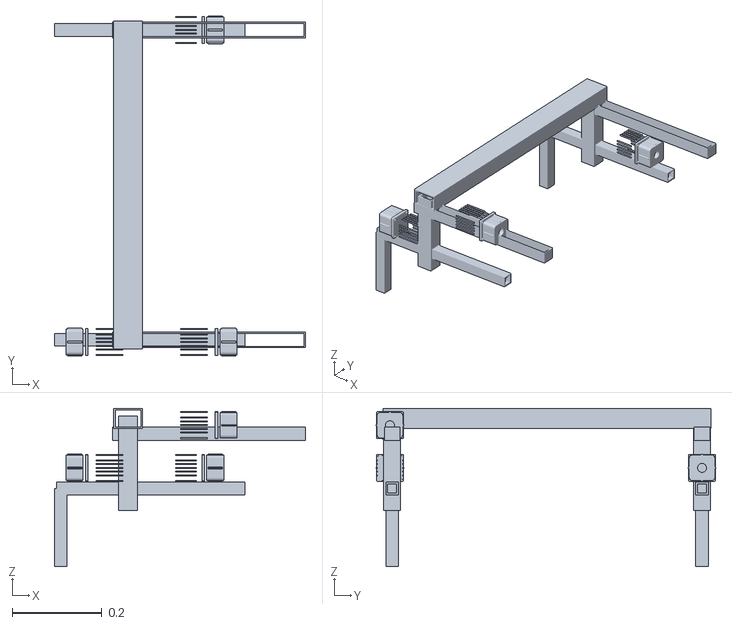
[picture p83: CAD file, 2026-10-20]
cargo_hold_v6/ros2_ws/src/cargo_robot_description/models/cargo_robot/meshes/pickup_head_link__00.stl
0.559 x 0.757 x 0.352
