adibhudapratama/BARELANG/cargo_hold_v6/ros2_ws/src/cargo_robot_description/models/cargo_robot/meshes/jaw_frame_link__03.stl

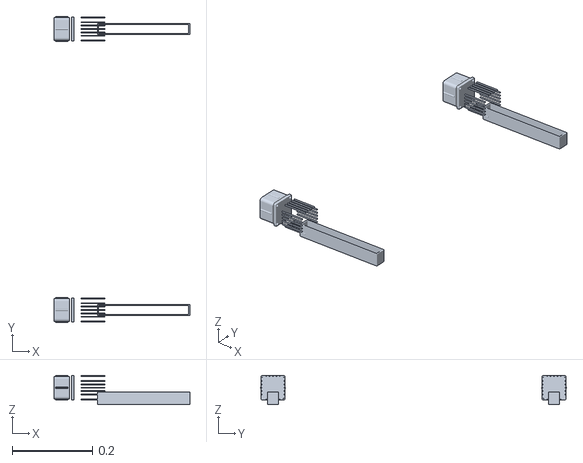
[picture p85: CAD file, 2026-10-20]
cargo_hold_v6/ros2_ws/src/cargo_robot_description/models/cargo_robot/meshes/jaw_frame_link__03.stl
0.338 x 0.762 x 0.073
