adibhudapratama/BARELANG/cargo_hold_v6/models/cargo_robot/meshes/extension_link__03.stl

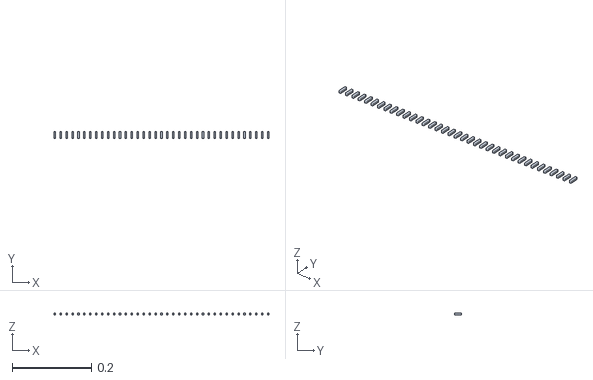
[picture p86: CAD file, 2026-10-20]
cargo_hold_v6/models/cargo_robot/meshes/extension_link__03.stl
0.544 x 0.018 x 0.005
