adibhudapratama/BARELANG/cargo_hold_v6/ros2_ws/src/cargo_robot_description/models/cargo_robot/meshes/rl_wheel_link__01.stl

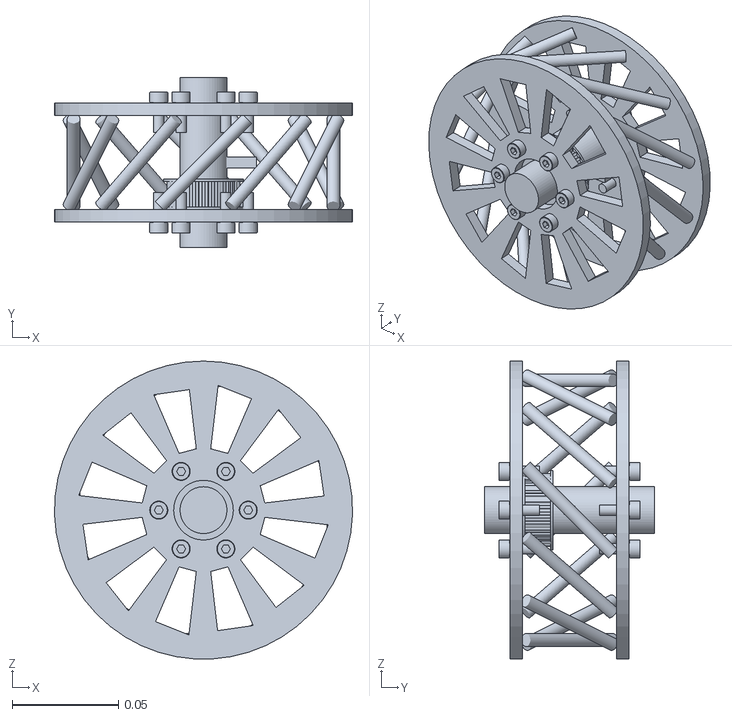
[picture p87: CAD file, 2026-10-20]
cargo_hold_v6/ros2_ws/src/cargo_robot_description/models/cargo_robot/meshes/rl_wheel_link__01.stl
0.14 x 0.08 x 0.14
