adibhudapratama/BARELANG/cargo_hold_v6/models/cargo_robot/meshes/fl_wheel_link.stl

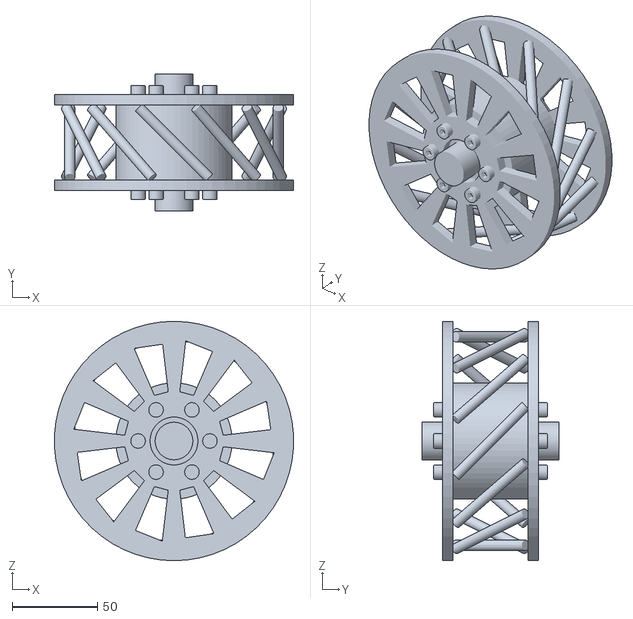
[picture p88: CAD file, 2026-10-20]
cargo_hold_v6/models/cargo_robot/meshes/fl_wheel_link.stl
139.8 x 80.0 x 140.0
