adibhudapratama/BARELANG/cargo_hold_v6/ros2_ws/src/cargo_robot_description/models/cargo_robot/meshes/head_stage1_link__01.stl

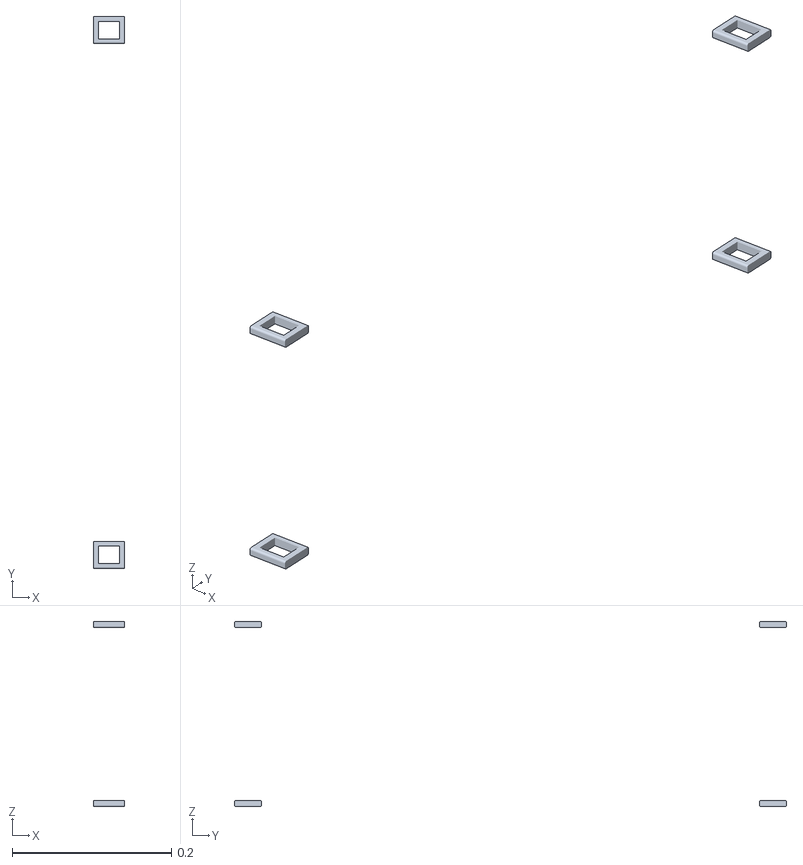
[picture p89: CAD file, 2026-10-20]
cargo_hold_v6/ros2_ws/src/cargo_robot_description/models/cargo_robot/meshes/head_stage1_link__01.stl
0.039 x 0.694 x 0.233
