adibhudapratama/BARELANG/cargo_hold_v6/models/cargo_robot/meshes/pickup_head_link__06.stl

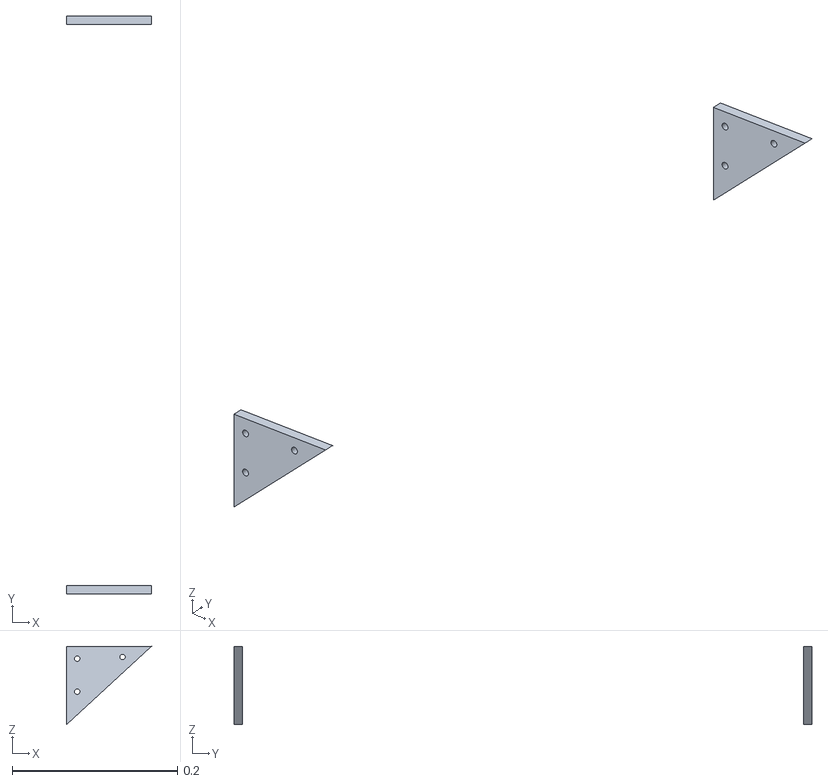
[picture p90: CAD file, 2026-10-20]
cargo_hold_v6/models/cargo_robot/meshes/pickup_head_link__06.stl
0.103 x 0.7 x 0.095
