adibhudapratama/BARELANG/cargo_hold_v6/models/cargo_robot/meshes/upper_slider_link__00.stl

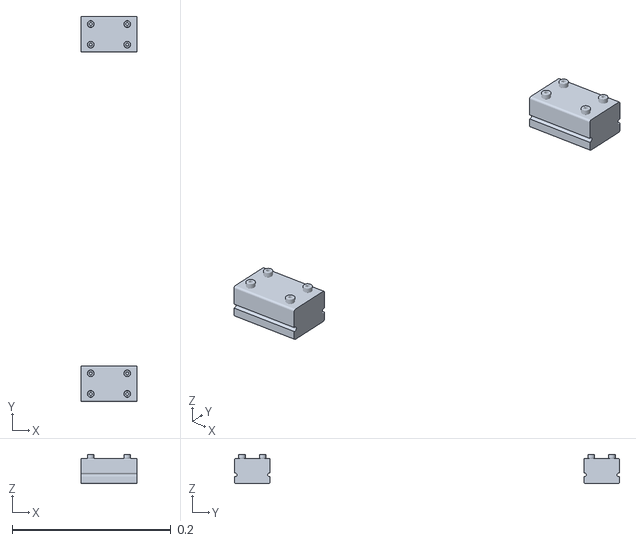
[picture p91: CAD file, 2026-10-20]
cargo_hold_v6/models/cargo_robot/meshes/upper_slider_link__00.stl
0.07 x 0.485 x 0.037
