adibhudapratama/BARELANG/cargo_hold_v6/ros2_ws/src/cargo_robot_description/models/cargo_robot/meshes/right_jaw_link__03.stl

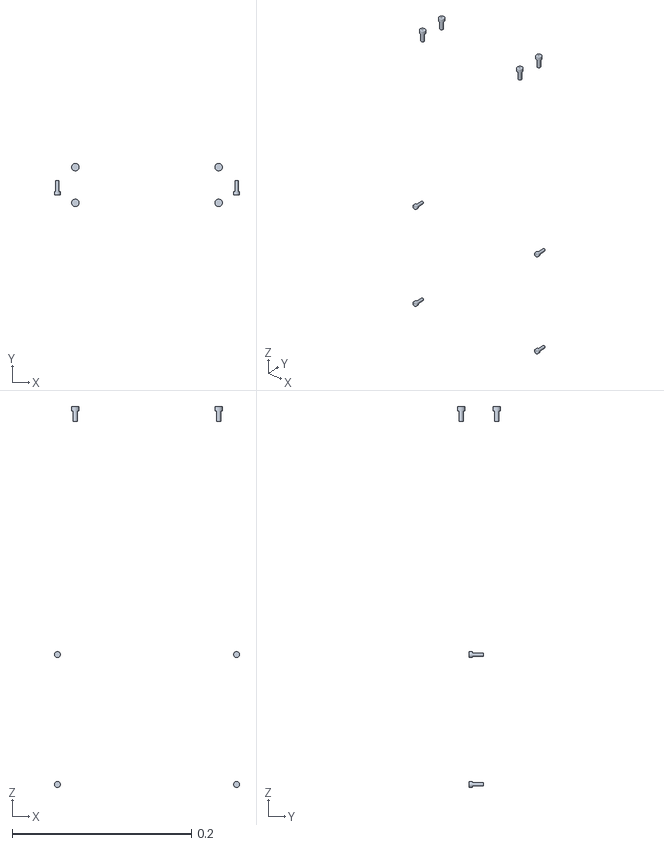
[picture p92: CAD file, 2026-10-20]
cargo_hold_v6/ros2_ws/src/cargo_robot_description/models/cargo_robot/meshes/right_jaw_link__03.stl
0.207 x 0.0485 x 0.425
