adibhudapratama/BARELANG/cargo_hold_v6/models/cargo_robot/meshes/conveyor_yaw_link__06.stl

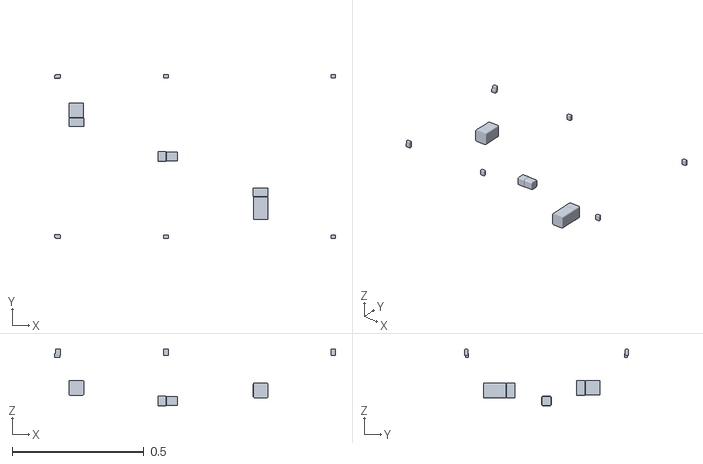
[picture p93: CAD file, 2026-10-20]
cargo_hold_v6/models/cargo_robot/meshes/conveyor_yaw_link__06.stl
1.07 x 0.622 x 0.215
