adibhudapratama/BARELANG/cargo_hold_v6/ros2_ws/src/cargo_robot_description/models/cargo_robot/meshes/conveyor_yaw_link__01.stl

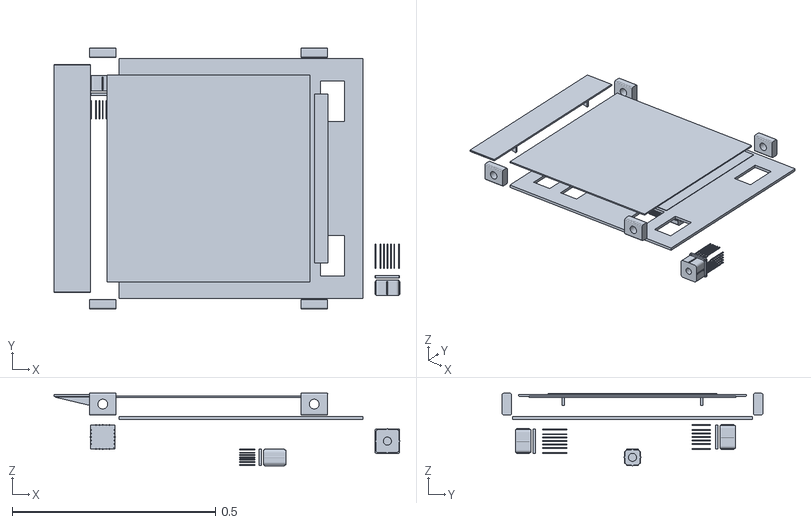
[picture p95: CAD file, 2026-10-20]
cargo_hold_v6/ros2_ws/src/cargo_robot_description/models/cargo_robot/meshes/conveyor_yaw_link__01.stl
0.851 x 0.642 x 0.179
