adibhudapratama/BARELANG/(list of files, cad)

Other CAD files:
cad/Robot_and_Cargo_Hold_Cutaway.step
cargo_hold_v6/ros2_ws/src/cargo_robot_description/models/cargo_robot/meshes/fr_roller08_link__01.stl
cad/Robot_and_Cargo_Hold.step
cargo_hold_v6/models/cargo_robot/meshes/fr_roller05_link__01.stl
cargo_hold_v6/models/cargo_robot/meshes/fl_roller05_link__01.stl
cargo_hold_v6/ros2_ws/src/cargo_robot_description/models/cargo_robot/meshes/rl_roller05_link__02.stl
cargo_hold_v6/ros2_ws/src/cargo_robot_description/models/cargo_robot/meshes/rl_roller07_link__01.stl
cargo_hold_v6/ros2_ws/src/cargo_robot_description/models/cargo_robot/meshes/fr_roller02_link__02.stl
cargo_hold_v6/ros2_ws/src/cargo_robot_description/models/cargo_robot/meshes/fr_roller06_link__01.stl
cargo_hold_v6/models/cargo_robot/meshes/fl_roller09_link__01.stl
cargo_hold_v6/ros2_ws/src/cargo_robot_description/models/cargo_robot/meshes/fl_roller09_link__00.stl
cargo_hold_v6/models/cargo_robot/meshes/rl_roller10_link__00.stl
cargo_hold_v6/ros2_ws/src/cargo_robot_description/models/cargo_robot/meshes/fr_roller06_link__02.stl
cargo_hold_v6/models/cargo_robot/meshes/fr_roller01_link__00.stl
cargo_hold_v6/models/cargo_robot/meshes/rl_roller10_link__02.stl
cargo_hold_v6/ros2_ws/src/cargo_robot_description/models/cargo_robot/meshes/fr_roller02_link__01.stl
cargo_hold_v6/ros2_ws/src/cargo_robot_description/models/cargo_robot/meshes/fl_roller11_link__00.stl
cargo_hold_v6/models/aircraft_hold/meshes/front_wall_1.stl
cargo_hold_v6/models/cargo_robot/meshes/fl_roller01_link__00.stl
cargo_hold_v6/ros2_ws/src/cargo_robot_description/models/cargo_robot/meshes/rl_roller00_link__02.stl
cargo_hold_v6/models/cargo_robot/meshes/fr_roller05_link__02.stl
cargo_hold_v6/ros2_ws/src/cargo_robot_description/models/cargo_robot/meshes/rr_roller01_link__01.stl
cargo_hold_v6/models/cargo_robot/meshes/rl_roller11_link__00.stl
cargo_hold_v6/ros2_ws/src/cargo_robot_description/models/cargo_robot/meshes/rl_roller08_link__02.stl
cargo_hold_v6/models/cargo_robot/meshes/rl_roller03_link__00.stl
cargo_hold_v6/models/aircraft_hold/meshes/rear_wall_0.stl
cargo_hold_v6/models/cargo_robot/meshes/rl_roller04_link__01.stl
cargo_hold_v6/ros2_ws/src/cargo_robot_description/models/cargo_robot/meshes/rr_roller00_link__02.stl
cargo_hold_v6/models/cargo_robot/meshes/rr_roller05_link.stl
cargo_hold_v6/ros2_ws/src/cargo_robot_description/models/cargo_robot/meshes/fl_roller03_link__01.stl
cargo_hold_v6/models/cargo_robot/meshes/rl_roller10_link.stl
cargo_hold_v6/models/cargo_robot/meshes/fl_roller08_link__01.stl
cargo_hold_v6/ros2_ws/src/cargo_robot_description/models/cargo_robot/meshes/rr_roller06_link__01.stl
cargo_hold_v6/models/cargo_robot/meshes/rr_roller04_link__02.stl
cargo_hold_v6/ros2_ws/src/cargo_robot_description/models/cargo_robot/meshes/fr_roller01_link__02.stl
cargo_hold_v6/models/cargo_robot/meshes/rl_roller01_link__01.stl
cargo_hold_v6/ros2_ws/src/cargo_robot_description/models/cargo_robot/meshes/rl_roller08_link__01.stl
cargo_hold_v6/models/cargo_robot/meshes/rr_roller01_link__01.stl
cargo_hold_v6/models/cargo_robot/meshes/rr_roller11_link__00.stl
cargo_hold_v6/models/cargo_robot/meshes/fr_roller02_link__02.stl
cargo_hold_v6/ros2_ws/src/cargo_robot_description/models/cargo_robot/meshes/rl_roller05_link__00.stl
cargo_hold_v6/models/cargo_robot/meshes/rl_roller00_link__00.stl
cargo_hold_v6/models/cargo_robot/meshes/fr_roller03_link__01.stl
cargo_hold_v6/models/cargo_robot/meshes/rr_roller09_link__01.stl
cargo_hold_v6/ros2_ws/src/cargo_robot_description/models/cargo_robot/meshes/rr_roller07_link__01.stl
cargo_hold_v6/models/cargo_robot/meshes/rr_roller10_link__01.stl
cargo_hold_v6/ros2_ws/src/cargo_robot_description/models/cargo_robot/meshes/rr_roller07_link__02.stl
cargo_hold_v6/ros2_ws/src/cargo_robot_description/models/cargo_robot/meshes/fl_wheel_link__01.stl
cargo_hold_v6/models/cargo_robot/meshes/fl_roller10_link.stl
cargo_hold_v6/ros2_ws/src/cargo_robot_description/models/cargo_robot/meshes/rr_roller11_link__02.stl
cargo_hold_v6/models/cargo_robot/meshes/fr_roller08_link__00.stl
cargo_hold_v6/ros2_ws/src/cargo_robot_description/models/cargo_robot/meshes/rl_roller10_link__00.stl
cargo_hold_v6/ros2_ws/src/cargo_robot_description/models/cargo_robot/meshes/fr_roller09_link__02.stl
cargo_hold_v6/models/cargo_robot/meshes/rr_roller01_link__00.stl
cargo_hold_v6/ros2_ws/src/cargo_robot_description/models/cargo_robot/meshes/fr_roller05_link__02.stl
cargo_hold_v6/models/cargo_robot/meshes/fr_roller07_link__02.stl
cargo_hold_v6/models/cargo_robot/meshes/fl_roller05_link.stl
cargo_hold_v6/ros2_ws/src/cargo_robot_description/models/cargo_robot/meshes/fl_roller01_link__00.stl
cargo_hold_v6/models/cargo_robot/meshes/fr_roller06_link__01.stl
cargo_hold_v6/models/cargo_robot/meshes/rr_roller02_link__00.stl
cargo_hold_v6/models/cargo_robot/meshes/base_link.stl
cargo_hold_v6/models/cargo_robot/meshes/base_link__00.stl
cargo_hold_v6/models/cargo_robot/meshes/base_link__01.stl
cargo_hold_v6/models/cargo_robot/meshes/base_link__05.stl
cargo_hold_v6/models/cargo_robot/meshes/base_link__06.stl
cargo_hold_v6/models/cargo_robot/meshes/base_link__07.stl
cargo_hold_v6/models/cargo_robot/meshes/base_link__09.stl
cargo_hold_v6/models/cargo_robot/meshes/conveyor_yaw_link.stl
cargo_hold_v6/models/cargo_robot/meshes/conveyor_yaw_link__02.stl
cargo_hold_v6/models/cargo_robot/meshes/conveyor_yaw_link__05.stl
cargo_hold_v6/models/cargo_robot/meshes/conveyor_yaw_link__08.stl
cargo_hold_v6/models/cargo_robot/meshes/conveyor_yaw_link__09.stl
cargo_hold_v6/models/cargo_robot/meshes/extension_link__00.stl
cargo_hold_v6/models/cargo_robot/meshes/extension_link__02.stl
cargo_hold_v6/models/cargo_robot/meshes/extension_link__04.stl
cargo_hold_v6/models/cargo_robot/meshes/extension_link__05.stl
cargo_hold_v6/models/cargo_robot/meshes/fl_roller00_link.stl
cargo_hold_v6/models/cargo_robot/meshes/fl_roller00_link__00.stl
cargo_hold_v6/models/cargo_robot/meshes/fl_roller00_link__02.stl
cargo_hold_v6/models/cargo_robot/meshes/fl_roller01_link.stl
cargo_hold_v6/models/cargo_robot/meshes/fl_roller01_link__01.stl
cargo_hold_v6/models/cargo_robot/meshes/fl_roller01_link__02.stl
cargo_hold_v6/models/cargo_robot/meshes/fl_roller02_link.stl
cargo_hold_v6/models/cargo_robot/meshes/fl_roller02_link__00.stl
cargo_hold_v6/models/cargo_robot/meshes/fl_roller02_link__01.stl
cargo_hold_v6/models/cargo_robot/meshes/fl_roller02_link__02.stl
cargo_hold_v6/models/cargo_robot/meshes/fl_roller03_link.stl
cargo_hold_v6/models/cargo_robot/meshes/fl_roller03_link__00.stl
cargo_hold_v6/models/cargo_robot/meshes/fl_roller03_link__01.stl
cargo_hold_v6/models/cargo_robot/meshes/fl_roller03_link__02.stl
cargo_hold_v6/models/cargo_robot/meshes/fl_roller04_link.stl
cargo_hold_v6/models/cargo_robot/meshes/fl_roller04_link__00.stl
cargo_hold_v6/models/cargo_robot/meshes/fl_roller04_link__01.stl
cargo_hold_v6/models/cargo_robot/meshes/fl_roller04_link__02.stl
cargo_hold_v6/models/cargo_robot/meshes/fl_roller05_link__00.stl
cargo_hold_v6/models/cargo_robot/meshes/fl_roller05_link__02.stl
cargo_hold_v6/models/cargo_robot/meshes/fl_roller06_link.stl
cargo_hold_v6/models/cargo_robot/meshes/fl_roller06_link__00.stl
cargo_hold_v6/models/cargo_robot/meshes/fl_roller06_link__01.stl
cargo_hold_v6/models/cargo_robot/meshes/fl_roller07_link.stl
cargo_hold_v6/models/cargo_robot/meshes/fl_roller07_link__00.stl
cargo_hold_v6/models/cargo_robot/meshes/fl_roller07_link__01.stl
cargo_hold_v6/models/cargo_robot/meshes/fl_roller07_link__02.stl
cargo_hold_v6/models/cargo_robot/meshes/fl_roller08_link.stl
cargo_hold_v6/models/cargo_robot/meshes/fl_roller08_link__00.stl
cargo_hold_v6/models/cargo_robot/meshes/fl_roller08_link__02.stl
cargo_hold_v6/models/cargo_robot/meshes/fl_roller09_link.stl
cargo_hold_v6/models/cargo_robot/meshes/fl_roller09_link__00.stl
cargo_hold_v6/models/cargo_robot/meshes/fl_roller09_link__02.stl
cargo_hold_v6/models/cargo_robot/meshes/fl_roller10_link__00.stl
cargo_hold_v6/models/cargo_robot/meshes/fl_roller10_link__01.stl
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
