adibhudapratama/BARELANG/cargo_hold_v6/cargo_robot.urdf

<?xml version='1.0' encoding='utf-8'?>
<robot name="cargo_robot">
  <link name="base_link">
    <inertial>
      <origin xyz="0 0 0.125" rpy="0 0 0" />
      <mass value="90" />
      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
    </inertial>
    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
  </link>
  <link name="fl_wheel_link">
    <inertial>
      <origin xyz="1.919716e-05 -0.000538893582 1.89679189e-15" rpy="0 0 0" />
      <mass value="2.8" />
      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
    </inertial>
    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
  </link>
  <link name="fl_roller00_link">
    <inertial>
      <origin xyz="-5.38018139e-17 -6.12640226e-16 -6.12624764e-16" rpy="0 0 0" />
      <mass value="0.1" />
      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
    </inertial>
    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
  </link>
  <link name="fl_roller01_link">
    <inertial>
      <origin xyz="-4.80063094e-15 -2.77163999e-15 -1.67087915e-16" rpy="0 0 0" />
      <mass value="0.1" />
      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
    </inertial>
    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
  </link>
  <link name="fl_roller02_link">
    <inertial>
      <origin xyz="6.97297485e-16 -3.38509973e-15 4.42485322e-15" rpy="0 0 0" />
      <mass value="0.1" />
      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
    </inertial>
    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
  </link>
  <link name="fl_roller03_link">
    <inertial>
      <origin xyz="1.26548299e-15 -1.2074831e-15 7.03138449e-17" rpy="0 0 0" />
      <mass value="0.1" />
      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
    </inertial>
    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
  </link>
  <link name="fl_roller04_link">
    <inertial>
      <origin xyz="2.05040653e-15 -4.40833152e-15 -3.48390519e-15" rpy="0 0 0" />
      <mass value="0.1" />
      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
    </inertial>
    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
  </link>
  <link name="fl_roller05_link">
    <inertial>
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
    <inertial>
      <origin xyz="0.325 0.000344325068 4.35823039e-17" rpy="0 0 0" />
      <mass value="2.5" />
      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
    </inertial>
    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
  </link>
  <link name="conveyor_yaw_link">
    <inertial>
      <origin xyz="-0.0924867076 -0.00370530051 -0.00912496014" rpy="0 0 0" />
      <mass value="17.0" />
      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
    </inertial>
    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
  </link>
  <link name="main_belt_roller_link">
    <inertial>
      <origin xyz="-4.00985488e-18 0.000713802109 7.49392457e-16" rpy="0 0 0" />
      <mass value="0.8" />
      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
    </inertial>
    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
  </link>
  <link name="extension_link">
    <inertial>
      <origin xyz="-0.103089335 0.1448863 0.0752981159" rpy="0 0 0" />
      <mass value="9.0" />
      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
    </inertial>
    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
  </link>
  <link name="head_stage1_link">
    <inertial>
      <origin xyz="0.04 -1.55473996e-17 0.164683361" rpy="0 0 0" />
      <mass value="2" />
      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
    </inertial>
    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
  </link>
  <link name="head_stage2_link">
    <inertial>
      <origin xyz="0.04 7.96305213e-16 0.164681925" rpy="0 0 0" />
      <mass value="2" />
      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
    </inertial>
    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
  </link>
  <link name="pickup_head_link">
    <inertial>
      <origin xyz="0.0911062449 -0.0711828246 0.336248659" rpy="0 0 0" />
      <mass value="14.0" />
      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
    </inertial>
    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
  </link>
  <link name="support_blade_link">
    <inertial>
      <origin xyz="0.183022715 -0.0106734079 0.0227912292" rpy="0 0 0" />
      <mass value="8" />
      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
    </inertial>
    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
  </link>
  <link name="nose_belt_roller_link">
    <inertial>
      <origin xyz="-4.01055307e-19 0 -9.66174971e-19" rpy="0 0 0" />
      <mass value="0.6" />
      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
    </inertial>
    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
  </link>
  <link name="jaw_frame_link">
    <inertial>
      <origin xyz="0.254447901 -0.00204725477 0.419056983" rpy="0 0 0" />
      <mass value="8.0" />
      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
    </inertial>
    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
  </link>
  <link name="left_jaw_link">
    <inertial>
      <origin xyz="-2.62850113e-18 -0.0083830353 0.147081111" rpy="0 0 0" />
      <mass value="3.8" />
      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
    </inertial>
    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
  </link>
  <link name="right_jaw_link">
    <inertial>
      <origin xyz="-6.61773379e-18 0.0083830353 0.147081111" rpy="0 0 0" />
      <mass value="3.8" />
      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
    </inertial>
    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
  </link>
  <joint name="fl_wheel_joint" type="continuous">
    <parent link="base_link" />
    <child link="fl_wheel_link" />
    <origin xyz="0.36 0.29 0.075" rpy="0 0 0" />
    <axis xyz="0 1 0" />
    <limit effort="10.9" velocity="5.4" />
    <dynamics damping="0.05" friction="0.01" />
  </joint>
  <joint name="fl_roller00_joint" type="continuous">
    <parent link="fl_wheel_link" />
    <child link="fl_roller00_link" />
    <origin xyz="0.061 0 0" rpy="0 0 0" />
    <axis xyz="0 -0.707106781 -0.707106781" />
    <limit effort="10" velocity="100" />
    <dynamics damping="0.05" friction="0.01" />
  </joint>
  <joint name="fl_roller01_joint" type="continuous">
    <parent link="fl_wheel_link" />
    <child link="fl_roller01_link" />
    <origin xyz="0.0528275496 0 0.0305" rpy="0 0 0" />
    <axis xyz="0.353553391 -0.707106781 -0.612372436" />
    <limit effort="10" velocity="100" />
    <dynamics damping="0.05" friction="0.01" />
  </joint>
  <joint name="fl_roller02_joint" type="continuous">
    <parent link="fl_wheel_link" />
    <child link="fl_roller02_link" />
    <origin xyz="0.0305 0 0.0528275496" rpy="0 0 0" />
    <axis xyz="0.612372436 -0.707106781 -0.353553391" />
    <limit effort="10" velocity="100" />
    <dynamics damping="0.05" friction="0.01" />
  </joint>
  <joint name="fl_roller03_joint" type="continuous">
    <parent link="fl_wheel_link" />
    <child link="fl_roller03_link" />
    <origin xyz="3.73517274e-18 0 0.061" rpy="0 0 0" />
    <axis xyz="0.707106781 -0.707106781 -4.32978028e-17" />
    <limit effort="10" velocity="100" />
    <dynamics damping="0.05" friction="0.01" />
  </joint>
  <joint name="fl_roller04_joint" type="continuous">
    <parent link="fl_wheel_link" />
    <child link="fl_roller04_link" />
    <origin xyz="-0.0305 0 0.0528275496" rpy="0 0 0" />
    <axis xyz="0.612372436 -0.707106781 0.353553391" />
    <limit effort="10" velocity="100" />
    <dynamics damping="0.05" friction="0.01" />
  </joint>
  <joint name="fl_roller05_joint" type="continuous">
    <parent link="fl_wheel_link" />
    <child link="fl_roller05_link" />
    <origin xyz="-0.0528275496 0 0.0305" rpy="0 0 0" />
    <axis xyz="0.353553391 -0.707106781 0.612372436" />
    <limit effort="10" velocity="100" />
    <dynamics damping="0.05" friction="0.01" />
  </joint>
  <joint name="fl_roller06_joint" type="continuous">
    <parent link="fl_wheel_link" />
    <child link="fl_roller06_link" />
    <origin xyz="-0.061 0 7.47034547e-18" rpy="0 0 0" />
    <axis xyz="8.65956056e-17 -0.707106781 0.707106781" />
    <limit effort="10" velocity="100" />
    <dynamics damping="0.05" friction="0.01" />
  </joint>
  <joint name="fl_roller07_joint" type="continuous">
    <parent link="fl_wheel_link" />
    <child link="fl_roller07_link" />
    <origin xyz="-0.0528275496 0 -0.0305" rpy="0 0 0" />
    <axis xyz="-0.353553391 -0.707106781 0.612372436" />
    <limit effort="10" velocity="100" />
    <dynamics damping="0.05" friction="0.01" />
  </joint>
  <joint name="fl_roller08_joint" type="continuous">
    <parent link="fl_wheel_link" />
    <child link="fl_roller08_link" />
    <origin xyz="-0.0305 0 -0.0528275496" rpy="0 0 0" />
    <axis xyz="-0.612372436 -0.707106781 0.353553391" />
    <limit effort="10" velocity="100" />
    <dynamics damping="0.05" friction="0.01" />
  </joint>
  <joint name="fl_roller09_joint" type="continuous">
    <parent link="fl_wheel_link" />
    <child link="fl_roller09_link" />
    <origin xyz="-1.12055182e-17 0 -0.061" rpy="0 0 0" />
    <axis xyz="-0.707106781 -0.707106781 1.29893408e-16" />
    <limit effort="10" velocity="100" />
    <dynamics damping="0.05" friction="0.01" />
  </joint>
  <joint name="fl_roller10_joint" type="continuous">
    <parent link="fl_wheel_link" />
    <child link="fl_roller10_link" />
    <origin xyz="0.0305 0 -0.0528275496" rpy="0 0 0" />
    <axis xyz="-0.612372436 -0.707106781 -0.353553391" />
    <limit effort="10" velocity="100" />
    <dynamics damping="0.05" friction="0.01" />
  </joint>
  <joint name="fl_roller11_joint" type="continuous">
    <parent link="fl_wheel_link" />
    <child link="fl_roller11_link" />
    <origin xyz="0.0528275496 0 -0.0305" rpy="0 0 0" />
    <axis xyz="-0.353553391 -0.707106781 -0.612372436" />
    <limit effort="10" velocity="100" />
    <dynamics damping="0.05" friction="0.01" />
  </joint>
  <joint name="fr_wheel_joint" type="continuous">
    <parent link="base_link" />
    <child link="fr_wheel_link" />
    <origin xyz="0.36 -0.29 0.075" rpy="0 0 0" />
    <axis xyz="0 1 0" />
    <limit effort="10.9" velocity="5.4" />
    <dynamics damping="0.05" friction="0.01" />
  </joint>
  <joint name="fr_roller00_joint" type="continuous">
    <parent link="fr_wheel_link" />
    <child link="fr_roller00_link" />
    <origin xyz="0.061 0 0" rpy="0 0 0" />
    <axis xyz="0 0.707106781 -0.707106781" />
    <limit effort="10" velocity="100" />
    <dynamics damping="0.05" friction="0.01" />
  </joint>
  <joint name="fr_roller01_joint" type="continuous">
    <parent link="fr_wheel_link" />
    <child link="fr_roller01_link" />
    <origin xyz="0.0528275496 0 0.0305" rpy="0 0 0" />
    <axis xyz="0.353553391 0.707106781 -0.612372436" />
    <limit effort="10" velocity="100" />
    <dynamics damping="0.05" friction="0.01" />
  </joint>
  <joint name="fr_roller02_joint" type="continuous">
    <parent link="fr_wheel_link" />
    <child link="fr_roller02_link" />
    <origin xyz="0.0305 0 0.0528275496" rpy="0 0 0" />
    <axis xyz="0.612372436 0.707106781 -0.353553391" />
    <limit effort="10" velocity="100" />
    <dynamics damping="0.05" friction="0.01" />
  </joint>
  <joint name="fr_roller03_joint" type="continuous">
    <parent link="fr_wheel_link" />
    <child link="fr_roller03_link" />
    <origin xyz="3.73517274e-18 0 0.061" rpy="0 0 0" />
    <axis xyz="0.707106781 0.707106781 -4.32978028e-17" />
    <limit effort="10" velocity="100" />
    <dynamics damping="0.05" friction="0.01" />
  </joint>
  <joint name="fr_roller04_joint" type="continuous">
    <parent link="fr_wheel_link" />
    <child link="fr_roller04_link" />
    <origin xyz="-0.0305 0 0.0528275496" rpy="0 0 0" />
    <axis xyz="0.612372436 0.707106781 0.353553391" />
    <limit effort="10" velocity="100" />
    <dynamics damping="0.05" friction="0.01" />
  </joint>
  <joint name="fr_roller05_joint" type="continuous">
    <parent link="fr_wheel_link" />
    <child link="fr_roller05_link" />
    <origin xyz="-0.0528275496 0 0.0305" rpy="0 0 0" />
    <axis xyz="0.353553391 0.707106781 0.612372436" />
    <limit effort="10" velocity="100" />
    <dynamics damping="0.05" friction="0.01" />
  </joint>
  <joint name="fr_roller06_joint" type="continuous">
    <parent link="fr_wheel_link" />
    <child link="fr_roller06_link" />
    <origin xyz="-0.061 0 7.47034547e-18" rpy="0 0 0" />
    <axis xyz="8.65956056e-17 0.707106781 0.707106781" />
    <limit effort="10" velocity="100" />
    <dynamics damping="0.05" friction="0.01" />
  </joint>
  <joint name="fr_roller07_joint" type="continuous">
    <parent link="fr_wheel_link" />
    <child link="fr_roller07_link" />
    <origin xyz="-0.0528275496 0 -0.0305" rpy="0 0 0" />
    <axis xyz="-0.353553391 0.707106781 0.612372436" />
    <limit effort="10" velocity="100" />
    <dynamics damping="0.05" friction="0.01" />
  </joint>
  <joint name="fr_roller08_joint" type="continuous">
    <parent link="fr_wheel_link" />
    <child link="fr_roller08_link" />
    <origin xyz="-0.0305 0 -0.0528275496" rpy="0 0 0" />
    <axis xyz="-0.612372436 0.707106781 0.353553391" />
    <limit effort="10" velocity="100" />
    <dynamics damping="0.05" friction="0.01" />
  </joint>
  <joint name="fr_roller09_joint" type="continuous">
    <parent link="fr_wheel_link" />
    <child link="fr_roller09_link" />
    <origin xyz="-1.12055182e-17 0 -0.061" rpy="0 0 0" />
    <axis xyz="-0.707106781 0.707106781 1.29893408e-16" />
    <limit effort="10" velocity="100" />
    <dynamics damping="0.05" friction="0.01" />
  </joint>
  <joint name="fr_roller10_joint" type="continuous">
    <parent link="fr_wheel_link" />
    <child link="fr_roller10_link" />
    <origin xyz="0.0305 0 -0.0528275496" rpy="0 0 0" />
    <axis xyz="-0.612372436 0.707106781 -0.353553391" />
    <limit effort="10" velocity="100" />
    <dynamics damping="0.05" friction="0.01" />
  </joint>
  <joint name="fr_roller11_joint" type="continuous">
    <parent link="fr_wheel_link" />
    <child link="fr_roller11_link" />
    <origin xyz="0.0528275496 0 -0.0305" rpy="0 0 0" />
    <axis xyz="-0.353553391 0.707106781 -0.612372436" />
    <limit effort="10" velocity="100" />
    <dynamics damping="0.05" friction="0.01" />
  </joint>
  <joint name="rl_wheel_joint" type="continuous">
    <parent link="base_link" />
    <child link="rl_wheel_link" />
    <origin xyz="-0.36 0.29 0.075" rpy="0 0 0" />
    <axis xyz="0 1 0" />
    <limit effort="10.9" velocity="5.4" />
    <dynamics damping="0.05" friction="0.01" />
  </joint>
  <joint name="rl_roller00_joint" type="continuous">
    <parent link="rl_wheel_link" />
    <child link="rl_roller00_link" />
    <origin xyz="0.061 0 0" rpy="0 0 0" />
    <axis xyz="0 0.707106781 -0.707106781" />
    <limit effort="10" velocity="100" />
    <dynamics damping="0.05" friction="0.01" />
  </joint>
  <joint name="rl_roller01_joint" type="continuous">
    <parent link="rl_wheel_link" />
    <child link="rl_roller01_link" />
    <origin xyz="0.0528275496 0 0.0305" rpy="0 0 0" />
    <axis xyz="0.353553391 0.707106781 -0.612372436" />
    <limit effort="10" velocity="100" />
    <dynamics damping="0.05" friction="0.01" />
  </joint>
  <joint name="rl_roller02_joint" type="continuous">
    <parent link="rl_wheel_link" />
    <child link="rl_roller02_link" />
    <origin xyz="0.0305 0 0.0528275496" rpy="0 0 0" />
    <axis xyz="0.612372436 0.707106781 -0.353553391" />
    <limit effort="10" velocity="100" />
    <dynamics damping="0.05" friction="0.01" />
  </joint>
  <joint name="rl_roller03_joint" type="continuous">
    <parent link="rl_wheel_link" />
    <child link="rl_roller03_link" />
    <origin xyz="3.73517274e-18 0 0.061" rpy="0 0 0" />
    <axis xyz="0.707106781 0.707106781 -4.32978028e-17" />
    <limit effort="10" velocity="100" />
    <dynamics damping="0.05" friction="0.01" />
  </joint>
  <joint name="rl_roller04_joint" type="continuous">
    <parent link="rl_wheel_link" />
    <child link="rl_roller04_link" />
    <origin xyz="-0.0305 0 0.0528275496" rpy="0 0 0" />
    <axis xyz="0.612372436 0.707106781 0.353553391" />
    <limit effort="10" velocity="100" />
    <dynamics damping="0.05" friction="0.01" />
  </joint>
  <joint name="rl_roller05_joint" type="continuous">
    <parent link="rl_wheel_link" />
    <child link="rl_roller05_link" />
    <origin xyz="-0.0528275496 0 0.0305" rpy="0 0 0" />
    <axis xyz="0.353553391 0.707106781 0.612372436" />
    <limit effort="10" velocity="100" />
    <dynamics damping="0.05" friction="0.01" />
  </joint>
  <joint name="rl_roller06_joint" type="continuous">
    <parent link="rl_wheel_link" />
    <child link="rl_roller06_link" />
    <origin xyz="-0.061 0 7.47034547e-18" rpy="0 0 0" />
    <axis xyz="8.65956056e-17 0.707106781 0.707106781" />
    <limit effort="10" velocity="100" />
    <dynamics damping="0.05" friction="0.01" />
  </joint>
  <joint name="rl_roller07_joint" type="continuous">
    <parent link="rl_wheel_link" />
    <child link="rl_roller07_link" />
    <origin xyz="-0.0528275496 0 -0.0305" rpy="0 0 0" />
    <axis xyz="-0.353553391 0.707106781 0.612372436" />
    <limit effort="10" velocity="100" />
    <dynamics damping="0.05" friction="0.01" />
  </joint>
  <joint name="rl_roller08_joint" type="continuous">
    <parent link="rl_wheel_link" />
    <child link="rl_roller08_link" />
    <origin xyz="-0.0305 0 -0.0528275496" rpy="0 0 0" />
    <axis xyz="-0.612372436 0.707106781 0.353553391" />
    <limit effort="10" velocity="100" />
    <dynamics damping="0.05" friction="0.01" />
  </joint>
  <joint name="rl_roller09_joint" type="continuous">
    <parent link="rl_wheel_link" />
    <child link="rl_roller09_link" />
    <origin xyz="-1.12055182e-17 0 -0.061" rpy="0 0 0" />
    <axis xyz="-0.707106781 0.707106781 1.29893408e-16" />
    <limit effort="10" velocity="100" />
    <dynamics damping="0.05" friction="0.01" />
  </joint>
  <joint name="rl_roller10_joint" type="continuous">
    <parent link="rl_wheel_link" />
    <child link="rl_roller10_link" />
    <origin xyz="0.0305 0 -0.0528275496" rpy="0 0 0" />
    <axis xyz="-0.612372436 0.707106781 -0.353553391" />
    <limit effort="10" velocity="100" />
    <dynamics damping="0.05" friction="0.01" />
  </joint>
  <joint name="rl_roller11_joint" type="continuous">
    <parent link="rl_wheel_link" />
    <child link="rl_roller11_link" />
    <origin xyz="0.0528275496 0 -0.0305" rpy="0 0 0" />
    <axis xyz="-0.353553391 0.707106781 -0.612372436" />
    <limit effort="10" velocity="100" />
    <dynamics damping="0.05" friction="0.01" />
  </joint>
  <joint name="rr_wheel_joint" type="continuous">
    <parent link="base_link" />
    <child link="rr_wheel_link" />
    <origin xyz="-0.36 -0.29 0.075" rpy="0 0 0" />
    <axis xyz="0 1 0" />
    <limit effort="10.9" velocity="5.4" />
    <dynamics damping="0.05" friction="0.01" />
  </joint>
  <joint name="rr_roller00_joint" type="continuous">
    <parent link="rr_wheel_link" />
    <child link="rr_roller00_link" />
    <origin xyz="0.061 0 0" rpy="0 0 0" />
    <axis xyz="0 -0.707106781 -0.707106781" />
    <limit effort="10" velocity="100" />
    <dynamics damping="0.05" friction="0.01" />
  </joint>
  <joint name="rr_roller01_joint" type="continuous">
    <parent link="rr_wheel_link" />
    <child link="rr_roller01_link" />
    <origin xyz="0.0528275496 0 0.0305" rpy="0 0 0" />
    <axis xyz="0.353553391 -0.707106781 -0.612372436" />
    <limit effort="10" velocity="100" />
    <dynamics damping="0.05" friction="0.01" />
  </joint>
  <joint name="rr_roller02_joint" type="continuous">
    <parent link="rr_wheel_link" />
    <child link="rr_roller02_link" />
    <origin xyz="0.0305 0 0.0528275496" rpy="0 0 0" />
    <axis xyz="0.612372436 -0.707106781 -0.353553391" />
    <limit effort="10" velocity="100" />
    <dynamics damping="0.05" friction="0.01" />
  </joint>
  <joint name="rr_roller03_joint" type="continuous">
    <parent link="rr_wheel_link" />
    <child link="rr_roller03_link" />
    <origin xyz="3.73517274e-18 0 0.061" rpy="0 0 0" />
    <axis xyz="0.707106781 -0.707106781 -4.32978028e-17" />
    <limit effort="10" velocity="100" />
    <dynamics damping="0.05" friction="0.01" />
  </joint>
  <joint name="rr_roller04_joint" type="continuous">
    <parent link="rr_wheel_link" />
    <child link="rr_roller04_link" />
    <origin xyz="-0.0305 0 0.0528275496" rpy="0 0 0" />
    <axis xyz="0.612372436 -0.707106781 0.353553391" />
    <limit effort="10" velocity="100" />
    <dynamics damping="0.05" friction="0.01" />
  </joint>
  <joint name="rr_roller05_joint" type="continuous">
    <parent link="rr_wheel_link" />
    <child link="rr_roller05_link" />
    <origin xyz="-0.0528275496 0 0.0305" rpy="0 0 0" />
    <axis xyz="0.353553391 -0.707106781 0.612372436" />
    <limit effort="10" velocity="100" />
    <dynamics damping="0.05" friction="0.01" />
  </joint>
  <joint name="rr_roller06_joint" type="continuous">
    <parent link="rr_wheel_link" />
    <child link="rr_roller06_link" />
    <origin xyz="-0.061 0 7.47034547e-18" rpy="0 0 0" />
    <axis xyz="8.65956056e-17 -0.707106781 0.707106781" />
    <limit effort="10" velocity="100" />
    <dynamics damping="0.05" friction="0.01" />
  </joint>
  <joint name="rr_roller07_joint" type="continuous">
    <parent link="rr_wheel_link" />
    <child link="rr_roller07_link" />
    <origin xyz="-0.0528275496 0 -0.0305" rpy="0 0 0" />
    <axis xyz="-0.353553391 -0.707106781 0.612372436" />
    <limit effort="10" velocity="100" />
    <dynamics damping="0.05" friction="0.01" />
  </joint>
  <joint name="rr_roller08_joint" type="continuous">
    <parent link="rr_wheel_link" />
    <child link="rr_roller08_link" />
    <origin xyz="-0.0305 0 -0.0528275496" rpy="0 0 0" />
    <axis xyz="-0.612372436 -0.707106781 0.353553391" />
    <limit effort="10" velocity="100" />
    <dynamics damping="0.05" friction="0.01" />
  </joint>
  <joint name="rr_roller09_joint" type="continuous">
    <parent link="rr_wheel_link" />
    <child link="rr_roller09_link" />
    <origin xyz="-1.12055182e-17 0 -0.061" rpy="0 0 0" />
    <axis xyz="-0.707106781 -0.707106781 1.29893408e-16" />
    <limit effort="10" velocity="100" />
    <dynamics damping="0.05" friction="0.01" />
  </joint>
  <joint name="rr_roller10_joint" type="continuous">
    <parent link="rr_wheel_link" />
    <child link="rr_roller10_link" />
    <origin xyz="0.0305 0 -0.0528275496" rpy="0 0 0" />
    <axis xyz="-0.612372436 -0.707106781 -0.353553391" />
    <limit effort="10" velocity="100" />
    <dynamics damping="0.05" friction="0.01" />
  </joint>
  <joint name="rr_roller11_joint" type="continuous">
    <parent link="rr_wheel_link" />
    <child link="rr_roller11_link" />
    <origin xyz="0.0528275496 0 -0.0305" rpy="0 0 0" />
    <axis xyz="-0.353553391 -0.707106781 -0.612372436" />
    <limit effort="10" velocity="100" />
    <dynamics damping="0.05" friction="0.01" />
  </joint>
  <joint name="lift_height_joint" type="prismatic">
    <parent link="base_link" />
    <child link="lift_carrier_link" />
    <origin xyz="0 0 0.28" rpy="0 0 0" />
    <axis xyz="0 0 1" />
    <limit effort="1800" velocity="0.02" lower="0" upper="0.31" />
    <dynamics damping="0.05" friction="0.01" />
  </joint>
  <joint name="lower_slider_joint" type="prismatic">
    <parent link="base_link" />
    <child link="lower_slider_link" />
    <origin xyz="0.319413525 0 0.16" rpy="0 0 0" />
    <axis xyz="1 0 0" />
    <limit effort="15000" velocity="0.1" lower="-0.309" upper="0" />
    <dynamics damping="0.05" friction="0.01" />
  </joint>
  <joint name="upper_slider_joint" type="prismatic">
    <parent link="lift_carrier_link" />
    <child link="upper_slider_link" />
    <origin xyz="0.319413525 0 0" rpy="0 0 0" />
    <axis xyz="1 0 0" />
    <limit effort="15000" velocity="0.1" lower="-0.309" upper="0" />
    <dynamics damping="0.05" friction="0.01" />
  </joint>
  <joint name="left_up_arm_joint" type="revolute">
    <parent link="base_link" />
    <child link="left_up_arm_link" />
    <origin xyz="-0.319413525 0.22 0.16" rpy="0 -0.185680506 0" />
    <axis xyz="0 1 0" />
    <limit effort="10000" velocity="3" lower="-0.86" upper="0" />
    <dynamics damping="0.05" friction="0.01" />
  </joint>
  <joint name="left_down_arm_joint" type="revolute">
    <parent link="lift_carrier_link" />
    <child link="left_down_arm_link" />
    <origin xyz="-0.319413525 0.24 0" rpy="0 0.185680506 0" />
    <axis xyz="0 1 0" />
    <limit effort="10000" velocity="3" lower="0" upper="0.86" />
    <dynamics damping="0.05" friction="0.01" />
  </joint>
  <joint name="right_up_arm_joint" type="revolute">
    <parent link="base_link" />
    <child link="right_up_arm_link" />
    <origin xyz="-0.319413525 -0.22 0.16" rpy="0 -0.185680506 0" />
    <axis xyz="0 1 0" />
    <limit effort="10000" velocity="3" lower="-0.86" upper="0" />
    <dynamics damping="0.05" friction="0.01" />
  </joint>
  <joint name="right_down_arm_joint" type="revolute">
    <parent link="lift_carrier_link" />
    <child link="right_down_arm_link" />
    <origin xyz="-0.319413525 -0.2 0" rpy="0 0.185680506 0" />
    <axis xyz="0 1 0" />
    <limit effort="10000" velocity="3" lower="0" upper="0.86" />
    <dynamics damping="0.05" friction="0.01" />
  </joint>
  <joint name="conveyor_yaw_joint" type="revolute">
    <parent link="lift_carrier_link" />
    <child link="conveyor_yaw_link" />
    <origin xyz="0 0 0.055" rpy="0 0 0" />
    <axis xyz="0 0 1" />
    <limit effort="39" velocity="0.4" lower="-1.5707963267948966" upper="1.5707963267948966" />
    <dynamics damping="0.05" friction="0.01" />
  </joint>
  <joint name="main_belt_joint" type="continuous">
    <parent link="conveyor_yaw_link" />
    <child link="main_belt_roller_link" />
    <origin xyz="-0.44 0 0.006" rpy="0 0 0" />
    <axis xyz="0 1 0" />
    <limit effort="11.5" velocity="12" />
    <dynamics damping="0.05" friction="0.01" />
  </joint>
  <joint name="extension_joint" type="prismatic">
    <parent link="conveyor_yaw_link" />
    <child link="extension_link" />
    <origin xyz="0.16 0 0" rpy="0 0 0" />
    <axis xyz="1 0 0" />
    <limit effort="200" velocity="0.18" lower="0" upper="0.44" />
    <dynamics damping="0.05" friction="0.01" />
  </joint>
  <joint name="head_z_joint" type="prismatic">
    <parent link="extension_link" />
    <child link="head_stage1_link" />
    <origin xyz="0 0 0" rpy="0 0 0" />
    <axis xyz="0 0 1" />
    <limit effort="2400" velocity="0.06" lower="-0.1725" upper="0" />
    <dynamics damping="0.05" friction="0.01" />
  </joint>
  <joint name="head_z_follower_joint" type="prismatic">
    <parent link="head_stage1_link" />
    <child link="head_stage2_link" />
    <origin xyz="0 0 0" rpy="0 0 0" />
    <axis xyz="0 0 1" />
    <limit effort="2400" velocity="0.06" lower="-0.1725" upper="0" />
    <dynamics damping="0.05" friction="0.01" />
    <mimic joint="head_z_joint" multiplier="1" />
  </joint>
  <joint name="head_mount_joint" type="fixed">
    <parent link="head_stage2_link" />
    <child link="pickup_head_link" />
    <origin xyz="0 0 0" rpy="0 0 0" />
    <axis xyz="0 0 1" />
  </joint>
  <joint name="support_blade_joint" type="prismatic">
    <parent link="pickup_head_link" />
    <child link="support_blade_link" />
    <origin xyz="0 0 0" rpy="0 0 0" />
    <axis xyz="1 0 0" />
    <limit effort="300" velocity="0.18" lower="-0.56" upper="0" />
    <dynamics damping="0.05" friction="0.01" />
  </joint>
  <joint name="nose_belt_joint" type="continuous">
    <parent link="support_blade_link" />
    <child link="nose_belt_roller_link" />
    <origin xyz="0.425 0 0.022" rpy="0 0 0" />
    <axis xyz="0 1 0" />
    <limit effort="5.2" velocity="40" />
    <dynamics damping="0.05" friction="0.01" />
  </joint>
  <joint name="jaw_lift_joint" type="prismatic">
    <parent link="pickup_head_link" />
    <child link="jaw_frame_link" />
    <origin xyz="0 0 0" rpy="0 0 0" />
    <axis xyz="0 0 1" />
    <limit effort="1200" velocity="0.04" lower="0" upper="0.035" />
    <dynamics damping="0.05" friction="0.01" />
  </joint>
  <joint name="left_jaw_joint" type="prismatic">
    <parent link="jaw_frame_link" />
    <child link="left_jaw_link" />
    <origin xyz="0.34 0.3275 0.005" rpy="0 0 0" />
    <axis xyz="0 -1 0" />
    <limit effort="450" velocity="0.08" lower="0" upper="0.22" />
    <dynamics damping="0.05" friction="0.01" />
  </joint>
  <joint name="right_jaw_joint" type="prismatic">
    <parent link="jaw_frame_link" />
    <child link="right_jaw_link" />
    <origin xyz="0.34 -0.3275 0.005" rpy="0 0 0" />
    <axis xyz="0 1 0" />
    <limit effort="450" velocity="0.08" lower="0" upper="0.22" />
    <dynamics damping="0.05" friction="0.01" />
  </joint>
</robot>
