adibhudapratama/BARELANG/cargo_hold_v6/models/cargo_robot/model.sdf

<?xml version='1.0' encoding='utf-8'?>
<sdf version="1.9">
  <model name="cargo_robot">
    <self_collide>false</self_collide>
    <link name="base_link">
      <pose>0 0 0 0 -0 0</pose>
      <inertial>
        <pose>0 0 0.125 0 0 0</pose>
        <mass>90</mass>
        <inertia>
          <ixx>3.9953428224941767</ixx>
          <iyy>8.268255509409917</iyy>
          <izz>11.456175698217882</izz>
          <ixy>0</ixy>
          <ixz>0</ixz>
          <iyz>0</iyz>
        </inertia>
      </inertial>
      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
    </link>
    <link name="fl_wheel_link">
      <pose>0.36 0.29 0.075 0 -0 0</pose>
      <inertial>
        <pose>1.919716e-05 -0.000538893582 1.89679189e-15 0 0 0</pose>
        <mass>2.8</mass>
        <inertia>
          <ixx>0.006076903115702001</ixx>
          <iyy>0.009168364304604193</iyy>
          <izz>0.0060812442816954</izz>
          <ixy>0</ixy>
          <ixz>0</ixz>
          <iyz>0</iyz>
        </inertia>
      </inertial>
      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
    </link>
    <link name="fl_roller00_link">
      <pose>0.421 0.29 0.075 0 -0 0</pose>
      <inertial>
        <pose>-5.38018139e-17 -6.12640226e-16 -6.12624764e-16 0 0 0</pose>
        <mass>0.1</mass>
        <inertia>
          <ixx>1.8759134470760344e-05</ixx>
          <iyy>1.634731386667269e-05</iyy>
          <izz>1.634731386667269e-05</izz>
          <ixy>0</ixy>
          <ixz>0</ixz>
          <iyz>0</iyz>
        </inertia>
      </inertial>
      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
    </link>
    <link name="fl_roller01_link">
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
          <ixy>0</ixy>
          <ixz>0</ixz>
          <iyz>0</iyz>
        </inertia>
      </inertial>
      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
    </link>
    <link name="rr_roller09_link">
      <pose>-0.36 -0.29 0.014 0 -0 0</pose>
      <inertial>
        <pose>-1.18466043e-15 -1.07110374e-15 -8.12245806e-17 0 0 0</pose>
        <mass>0.1</mass>
        <inertia>
          <ixx>1.6351254099783484e-05</ixx>
          <iyy>1.6351254099783484e-05</iyy>
          <izz>1.875744751646035e-05</izz>
          <ixy>0</ixy>
          <ixz>0</ixz>
          <iyz>0</iyz>
        </inertia>
      </inertial>
      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
    </link>
    <link name="rr_roller10_link">
      <pose>-0.3295 -0.29 0.0221724504 0 -0 0</pose>
      <inertial>
        <pose>-4.44624561e-16 -2.95006192e-15 4.52642647e-15 0 0 0</pose>
        <mass>0.1</mass>
        <inertia>
          <ixx>1.6823329163780988e-05</ixx>
          <iyy>1.625115929989278e-05</iyy>
          <izz>1.818582244686912e-05</izz>
          <ixy>0</ixy>
          <ixz>0</ixz>
          <iyz>0</iyz>
        </inertia>
      </inertial>
      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
    </link>
    <link name="rr_roller11_link">
      <pose>-0.30717245 -0.29 0.0445 0 -0 0</pose>
      <inertial>
        <pose>4.34701493e-15 -3.362509e-15 -8.24708592e-16 0 0 0</pose>
        <mass>0.1</mass>
        <inertia>
          <ixx>1.818109156598612e-05</ixx>
          <iyy>1.62461794456076e-05</iyy>
          <izz>1.682077018583824e-05</izz>
          <ixy>0</ixy>
          <ixz>0</ixz>
          <iyz>0</iyz>
        </inertia>
      </inertial>
      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
    </link>
    <link name="lift_carrier_link">
      <pose>0 0 0.28 0 -0 0</pose>
      <inertial>
        <pose>-1.23349068e-15 3.32838138e-16 -0.000799687562 0 0 0</pose>
        <mass>8</mass>
        <inertia>
          <ixx>0.23363596450409627</ixx>
          <iyy>0.44983596456542957</iyy>
          <izz>0.6803333337093337</izz>
          <ixy>0</ixy>
          <ixz>0</ixz>
          <iyz>0</iyz>
        </inertia>
      </inertial>
      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
    </link>
    <link name="lower_slider_link">
      <pose>0.319413525 0 0.16 0 -0 0</pose>
      <inertial>
        <pose>-0.00231525831 -3.73097709e-14 0.000251247183 0 0 0</pose>
        <mass>1.5</mass>
        <inertia>
          <ixx>0.02985434818136928</ixx>
          <iyy>0.0010628326802819815</iyy>
          <izz>0.03001681592951024</izz>
          <ixy>0</ixy>
          <ixz>0</ixz>
          <iyz>0</iyz>
        </inertia>
      </inertial>
      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
    </link>
    <link name="upper_slider_link">
      <pose>0.319413525 0 0.28 0 -0 0</pose>
      <inertial>
        <pose>-2.4516858e-17 -5.37931033e-14 0.000360319855 0 0 0</pose>
        <mass>1.5</mass>
        <inertia>
          <ixx>0.029575437872142018</ixx>
          <iyy>0.0007839223710547176</iyy>
          <izz>0.03001681592951024</izz>
          <ixy>0</ixy>
          <ixz>0</ixz>
          <iyz>0</iyz>
        </inertia>
      </inertial>
      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
    </link>
    <link name="left_up_arm_link">
      <pose>-0.319413525 0.22 0.16 0 -0.185680506 0</pose>
      <inertial>
        <pose>0.325 0.000505923861 4.35925137e-17 0 0 0</pose>
        <mass>2.5</mass>
        <inertia>
          <ixx>0.0015526681523724288</ixx>
          <iyy>0.10107740038867347</iyy>
          <izz>0.10178323697277579</izz>
          <ixy>0</ixy>
          <ixz>0</ixz>
          <iyz>0</iyz>
        </inertia>
      </inertial>
      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
    </link>
    <link name="left_down_arm_link">
      <pose>-0.319413525 0.24 0.28 0 0.185680506 0</pose>
      <inertial>
        <pose>0.325 0.000344325068 4.35823039e-17 0 0 0</pose>
        <mass>2.5</mass>
        <inertia>
          <ixx>0.0015526681523724288</ixx>
          <iyy>0.10107740038867347</iyy>
          <izz>0.10178323697277579</izz>
          <ixy>0</ixy>
          <ixz>0</ixz>
          <iyz>0</iyz>
        </inertia>
      </inertial>
      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
    </link>
    <link name="right_up_arm_link">
      <pose>-0.319413525 -0.22 0.16 0 -0.185680506 0</pose>
      <inertial>
        <pose>0.325 0.000505923861 4.35925137e-17 0 0 0</pose>
        <mass>2.5</mass>
        <inertia>
          <ixx>0.0015526681523724288</ixx>
          <iyy>0.10107740038867347</iyy>
          <izz>0.10178323697277579</izz>
          <ixy>0</ixy>
          <ixz>0</ixz>
          <iyz>0</iyz>
        </inertia>
      </inertial>
      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
    </link>
    <link name="right_down_arm_link">
      <pose>-0.319413525 -0.2 0.28 0 0.185680506 0</pose>
      <inertial>
        <pose>0.325 0.000344325068 4.35823039e-17 0 0 0</pose>
        <mass>2.5</mass>
        <inertia>
          <ixx>0.0015526681523724288</ixx>
          <iyy>0.10107740038867347</iyy>
          <izz>0.10178323697277579</izz>
          <ixy>0</ixy>
          <ixz>0</ixz>
          <iyz>0</iyz>
        </inertia>
      </inertial>
      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
        <mass>3.8</mass>
        <inertia>
          <ixx>0.06379205301120962</ixx>
          <iyy>0.08566194481380118</iyy>
          <izz>0.024305100084376485</izz>
          <ixy>0</ixy>
          <ixz>0</ixz>
          <iyz>0</iyz>
        </inertia>
      </inertial>
      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
    </link>
    <link name="right_jaw_link">
      <pose>0.5 -0.3275 0.34 0 -0 0</pose>
      <inertial>
        <pose>-6.61773379e-18 0.0083830353 0.147081111 0 0 0</pose>
        <mass>3.8</mass>
        <inertia>
          <ixx>0.06379205301120962</ixx>
          <iyy>0.08566194481380118</iyy>
          <izz>0.024305100084376485</izz>
          <ixy>0</ixy>
          <ixz>0</ixz>
          <iyz>0</iyz>
        </inertia>
      </inertial>
      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
    </link>
    <joint name="fl_wheel_joint" type="revolute">
      <pose relative_to="fl_wheel_link">0 0 0 0 0 0</pose>
      <parent>base_link</parent>
      <child>fl_wheel_link</child>
      <axis>
        <xyz>0 1 0</xyz>
        <limit>
          <lower>-1e+16</lower>
          <upper>1e+16</upper>
          <effort>10.9</effort>
          <velocity>5.4</velocity>
        </limit>
        <dynamics>
          <damping>0.05</damping>
        </dynamics>
      </axis>
    </joint>
    <joint name="fl_roller00_joint" type="revolute">
      <pose relative_to="fl_roller00_link">0 0 0 0 0 0</pose>
      <parent>fl_wheel_link</parent>
      <child>fl_roller00_link</child>
      <axis>
        <xyz>0 -0.707106781 -0.707106781</xyz>
        <limit>
          <lower>-1e+16</lower>
          <upper>1e+16</upper>
          <effort>10</effort>
          <velocity>100</velocity>
        </limit>
        <dynamics>
          <damping>0.003</damping>
        </dynamics>
      </axis>
    </joint>
    <joint name="fl_roller01_joint" type="revolute">
      <pose relative_to="fl_roller01_link">0 0 0 0 0 0</pose>
      <parent>fl_wheel_link</parent>
      <child>fl_roller01_link</child>
      <axis>
        <xyz>0.353553391 -0.707106781 -0.612372436</xyz>
        <limit>
          <lower>-1e+16</lower>
          <upper>1e+16</upper>
          <effort>10</effort>
          <velocity>100</velocity>
        </limit>
        <dynamics>
          <damping>0.003</damping>
        </dynamics>
      </axis>
    </joint>
    <joint name="fl_roller02_joint" type="revolute">
      <pose relative_to="fl_roller02_link">0 0 0 0 0 0</pose>
      <parent>fl_wheel_link</parent>
      <child>fl_roller02_link</child>
      <axis>
        <xyz>0.612372436 -0.707106781 -0.353553391</xyz>
        <limit>
          <lower>-1e+16</lower>
          <upper>1e+16</upper>
          <effort>10</effort>
          <velocity>100</velocity>
        </limit>
        <dynamics>
          <damping>0.003</damping>
        </dynamics>
      </axis>
    </joint>
    <joint name="fl_roller03_joint" type="revolute">
      <pose relative_to="fl_roller03_link">0 0 0 0 0 0</pose>
      <parent>fl_wheel_link</parent>
      <child>fl_roller03_link</child>
      <axis>
        <xyz>0.707106781 -0.707106781 -4.32978028e-17</xyz>
        <limit>
          <lower>-1e+16</lower>
          <upper>1e+16</upper>
          <effort>10</effort>
          <velocity>100</velocity>
        </limit>
        <dynamics>
          <damping>0.003</damping>
        </dynamics>
      </axis>
    </joint>
    <joint name="fl_roller04_joint" type="revolute">
      <pose relative_to="fl_roller04_link">0 0 0 0 0 0</pose>
      <parent>fl_wheel_link</parent>
      <child>fl_roller04_link</child>
      <axis>
        <xyz>0.612372436 -0.707106781 0.353553391</xyz>
        <limit>
          <lower>-1e+16</lower>
          <upper>1e+16</upper>
          <effort>10</effort>
          <velocity>100</velocity>
        </limit>
        <dynamics>
          <damping>0.003</damping>
        </dynamics>
      </axis>
    </joint>
    <joint name="fl_roller05_joint" type="revolute">
      <pose relative_to="fl_roller05_link">0 0 0 0 0 0</pose>
      <parent>fl_wheel_link</parent>
      <child>fl_roller05_link</child>
      <axis>
        <xyz>0.353553391 -0.707106781 0.612372436</xyz>
        <limit>
          <lower>-1e+16</lower>
          <upper>1e+16</upper>
          <effort>10</effort>
          <velocity>100</velocity>
        </limit>
        <dynamics>
          <damping>0.003</damping>
        </dynamics>
      </axis>
    </joint>
    <joint name="fl_roller06_joint" type="revolute">
      <pose relative_to="fl_roller06_link">0 0 0 0 0 0</pose>
      <parent>fl_wheel_link</parent>
      <child>fl_roller06_link</child>
      <axis>
        <xyz>8.65956056e-17 -0.707106781 0.707106781</xyz>
        <limit>
          <lower>-1e+16</lower>
          <upper>1e+16</upper>
          <effort>10</effort>
          <velocity>100</velocity>
        </limit>
        <dynamics>
          <damping>0.003</damping>
        </dynamics>
      </axis>
    </joint>
    <joint name="fl_roller07_joint" type="revolute">
      <pose relative_to="fl_roller07_link">0 0 0 0 0 0</pose>
      <parent>fl_wheel_link</parent>
      <child>fl_roller07_link</child>
      <axis>
        <xyz>-0.353553391 -0.707106781 0.612372436</xyz>
        <limit>
          <lower>-1e+16</lower>
          <upper>1e+16</upper>
          <effort>10</effort>
          <velocity>100</velocity>
        </limit>
        <dynamics>
          <damping>0.003</damping>
        </dynamics>
      </axis>
    </joint>
    <joint name="fl_roller08_joint" type="revolute">
      <pose relative_to="fl_roller08_link">0 0 0 0 0 0</pose>
      <parent>fl_wheel_link</parent>
      <child>fl_roller08_link</child>
      <axis>
        <xyz>-0.612372436 -0.707106781 0.353553391</xyz>
        <limit>
          <lower>-1e+16</lower>
          <upper>1e+16</upper>
          <effort>10</effort>
          <velocity>100</velocity>
        </limit>
        <dynamics>
          <damping>0.003</damping>
        </dynamics>
      </axis>
    </joint>
    <joint name="fl_roller09_joint" type="revolute">
      <pose relative_to="fl_roller09_link">0 0 0 0 0 0</pose>
      <parent>fl_wheel_link</parent>
      <child>fl_roller09_link</child>
      <axis>
        <xyz>-0.707106781 -0.707106781 1.29893408e-16</xyz>
        <limit>
          <lower>-1e+16</lower>
          <upper>1e+16</upper>
          <effort>10</effort>
          <velocity>100</velocity>
        </limit>
        <dynamics>
          <damping>0.003</damping>
        </dynamics>
      </axis>
    </joint>
    <joint name="fl_roller10_joint" type="revolute">
      <pose relative_to="fl_roller10_link">0 0 0 0 0 0</pose>
      <parent>fl_wheel_link</parent>
      <child>fl_roller10_link</child>
      <axis>
        <xyz>-0.612372436 -0.707106781 -0.353553391</xyz>
        <limit>
          <lower>-1e+16</lower>
          <upper>1e+16</upper>
          <effort>10</effort>
          <velocity>100</velocity>
        </limit>
        <dynamics>
          <damping>0.003</damping>
        </dynamics>
      </axis>
    </joint>
    <joint name="fl_roller11_joint" type="revolute">
      <pose relative_to="fl_roller11_link">0 0 0 0 0 0</pose>
      <parent>fl_wheel_link</parent>
      <child>fl_roller11_link</child>
      <axis>
        <xyz>-0.353553391 -0.707106781 -0.612372436</xyz>
        <limit>
          <lower>-1e+16</lower>
          <upper>1e+16</upper>
          <effort>10</effort>
          <velocity>100</velocity>
        </limit>
        <dynamics>
          <damping>0.003</damping>
        </dynamics>
      </axis>
    </joint>
    <joint name="fr_wheel_joint" type="revolute">
      <pose relative_to="fr_wheel_link">0 0 0 0 0 0</pose>
      <parent>base_link</parent>
      <child>fr_wheel_link</child>
      <axis>
        <xyz>0 1 0</xyz>
        <limit>
          <lower>-1e+16</lower>
          <upper>1e+16</upper>
          <effort>10.9</effort>
          <velocity>5.4</velocity>
        </limit>
        <dynamics>
          <damping>0.05</damping>
        </dynamics>
      </axis>
    </joint>
    <joint name="fr_roller00_joint" type="revolute">
      <pose relative_to="fr_roller00_link">0 0 0 0 0 0</pose>
      <parent>fr_wheel_link</parent>
      <child>fr_roller00_link</child>
      <axis>
        <xyz>0 0.707106781 -0.707106781</xyz>
        <limit>
          <lower>-1e+16</lower>
          <upper>1e+16</upper>
          <effort>10</effort>
          <velocity>100</velocity>
        </limit>
        <dynamics>
          <damping>0.003</damping>
        </dynamics>
      </axis>
    </joint>
    <joint name="fr_roller01_joint" type="revolute">
      <pose relative_to="fr_roller01_link">0 0 0 0 0 0</pose>
      <parent>fr_wheel_link</parent>
      <child>fr_roller01_link</child>
      <axis>
        <xyz>0.353553391 0.707106781 -0.612372436</xyz>
        <limit>
          <lower>-1e+16</lower>
          <upper>1e+16</upper>
          <effort>10</effort>
          <velocity>100</velocity>
        </limit>
        <dynamics>
          <damping>0.003</damping>
        </dynamics>
      </axis>
    </joint>
    <joint name="fr_roller02_joint" type="revolute">
      <pose relative_to="fr_roller02_link">0 0 0 0 0 0</pose>
      <parent>fr_wheel_link</parent>
      <child>fr_roller02_link</child>
      <axis>
        <xyz>0.612372436 0.707106781 -0.353553391</xyz>
        <limit>
          <lower>-1e+16</lower>
          <upper>1e+16</upper>
          <effort>10</effort>
          <velocity>100</velocity>
        </limit>
        <dynamics>
          <damping>0.003</damping>
        </dynamics>
      </axis>
    </joint>
    <joint name="fr_roller03_joint" type="revolute">
      <pose relative_to="fr_roller03_link">0 0 0 0 0 0</pose>
      <parent>fr_wheel_link</parent>
      <child>fr_roller03_link</child>
      <axis>
        <xyz>0.707106781 0.707106781 -4.32978028e-17</xyz>
        <limit>
          <lower>-1e+16</lower>
          <upper>1e+16</upper>
          <effort>10</effort>
          <velocity>100</velocity>
        </limit>
        <dynamics>
          <damping>0.003</damping>
        </dynamics>
      </axis>
    </joint>
    <joint name="fr_roller04_joint" type="revolute">
      <pose relative_to="fr_roller04_link">0 0 0 0 0 0</pose>
      <parent>fr_wheel_link</parent>
      <child>fr_roller04_link</child>
      <axis>
        <xyz>0.612372436 0.707106781 0.353553391</xyz>
        <limit>
          <lower>-1e+16</lower>
          <upper>1e+16</upper>
          <effort>10</effort>
          <velocity>100</velocity>
        </limit>
        <dynamics>
          <damping>0.003</damping>
        </dynamics>
      </axis>
    </joint>
    <joint name="fr_roller05_joint" type="revolute">
      <pose relative_to="fr_roller05_link">0 0 0 0 0 0</pose>
      <parent>fr_wheel_link</parent>
      <child>fr_roller05_link</child>
      <axis>
        <xyz>0.353553391 0.707106781 0.612372436</xyz>
        <limit>
          <lower>-1e+16</lower>
          <upper>1e+16</upper>
          <effort>10</effort>
          <velocity>100</velocity>
        </limit>
        <dynamics>
          <damping>0.003</damping>
        </dynamics>
      </axis>
    </joint>
    <joint name="fr_roller06_joint" type="revolute">
      <pose relative_to="fr_roller06_link">0 0 0 0 0 0</pose>
      <parent>fr_wheel_link</parent>
      <child>fr_roller06_link</child>
      <axis>
        <xyz>8.65956056e-17 0.707106781 0.707106781</xyz>
        <limit>
          <lower>-1e+16</lower>
          <upper>1e+16</upper>
          <effort>10</effort>
          <velocity>100</velocity>
        </limit>
        <dynamics>
          <damping>0.003</damping>
        </dynamics>
      </axis>
    </joint>
    <joint name="fr_roller07_joint" type="revolute">
      <pose relative_to="fr_roller07_link">0 0 0 0 0 0</pose>
      <parent>fr_wheel_link</parent>
      <child>fr_roller07_link</child>
      <axis>
        <xyz>-0.353553391 0.707106781 0.612372436</xyz>
        <limit>
          <lower>-1e+16</lower>
          <upper>1e+16</upper>
          <effort>10</effort>
          <velocity>100</velocity>
        </limit>
        <dynamics>
          <damping>0.003</damping>
        </dynamics>
      </axis>
    </joint>
    <joint name="fr_roller08_joint" type="revolute">
      <pose relative_to="fr_roller08_link">0 0 0 0 0 0</pose>
      <parent>fr_wheel_link</parent>
      <child>fr_roller08_link</child>
      <axis>
        <xyz>-0.612372436 0.707106781 0.353553391</xyz>
        <limit>
          <lower>-1e+16</lower>
          <upper>1e+16</upper>
          <effort>10</effort>
          <velocity>100</velocity>
        </limit>
        <dynamics>
          <damping>0.003</damping>
        </dynamics>
      </axis>
    </joint>
    <joint name="fr_roller09_joint" type="revolute">
      <pose relative_to="fr_roller09_link">0 0 0 0 0 0</pose>
      <parent>fr_wheel_link</parent>
      <child>fr_roller09_link</child>
      <axis>
        <xyz>-0.707106781 0.707106781 1.29893408e-16</xyz>
        <limit>
          <lower>-1e+16</lower>
          <upper>1e+16</upper>
          <effort>10</effort>
          <velocity>100</velocity>
        </limit>
        <dynamics>
          <damping>0.003</damping>
        </dynamics>
      </axis>
    </joint>
    <joint name="fr_roller10_joint" type="revolute">
      <pose relative_to="fr_roller10_link">0 0 0 0 0 0</pose>
      <parent>fr_wheel_link</parent>
      <child>fr_roller10_link</child>
      <axis>
        <xyz>-0.612372436 0.707106781 -0.353553391</xyz>
        <limit>
          <lower>-1e+16</lower>
          <upper>1e+16</upper>
          <effort>10</effort>
          <velocity>100</velocity>
        </limit>
        <dynamics>
          <damping>0.003</damping>
        </dynamics>
      </axis>
    </joint>
    <joint name="fr_roller11_joint" type="revolute">
      <pose relative_to="fr_roller11_link">0 0 0 0 0 0</pose>
      <parent>fr_wheel_link</parent>
      <child>fr_roller11_link</child>
      <axis>
        <xyz>-0.353553391 0.707106781 -0.612372436</xyz>
        <limit>
          <lower>-1e+16</lower>
          <upper>1e+16</upper>
          <effort>10</effort>
          <velocity>100</velocity>
        </limit>
        <dynamics>
          <damping>0.003</damping>
        </dynamics>
      </axis>
    </joint>
    <joint name="rl_wheel_joint" type="revolute">
      <pose relative_to="rl_wheel_link">0 0 0 0 0 0</pose>
      <parent>base_link</parent>
      <child>rl_wheel_link</child>
      <axis>
        <xyz>0 1 0</xyz>
        <limit>
          <lower>-1e+16</lower>
          <upper>1e+16</upper>
          <effort>10.9</effort>
          <velocity>5.4</velocity>
        </limit>
        <dynamics>
          <damping>0.05</damping>
        </dynamics>
      </axis>
    </joint>
    <joint name="rl_roller00_joint" type="revolute">
      <pose relative_to="rl_roller00_link">0 0 0 0 0 0</pose>
      <parent>rl_wheel_link</parent>
      <child>rl_roller00_link</child>
      <axis>
        <xyz>0 0.707106781 -0.707106781</xyz>
        <limit>
          <lower>-1e+16</lower>
          <upper>1e+16</upper>
          <effort>10</effort>
          <velocity>100</velocity>
        </limit>
        <dynamics>
          <damping>0.003</damping>
        </dynamics>
      </axis>
    </joint>
    <joint name="rl_roller01_joint" type="revolute">
      <pose relative_to="rl_roller01_link">0 0 0 0 0 0</pose>
      <parent>rl_wheel_link</parent>
      <child>rl_roller01_link</child>
      <axis>
        <xyz>0.353553391 0.707106781 -0.612372436</xyz>
        <limit>
          <lower>-1e+16</lower>
          <upper>1e+16</upper>
          <effort>10</effort>
          <velocity>100</velocity>
        </limit>
        <dynamics>
          <damping>0.003</damping>
        </dynamics>
      </axis>
    </joint>
    <joint name="rl_roller02_joint" type="revolute">
      <pose relative_to="rl_roller02_link">0 0 0 0 0 0</pose>
      <parent>rl_wheel_link</parent>
      <child>rl_roller02_link</child>
      <axis>
        <xyz>0.612372436 0.707106781 -0.353553391</xyz>
        <limit>
          <lower>-1e+16</lower>
          <upper>1e+16</upper>
          <effort>10</effort>
          <velocity>100</velocity>
        </limit>
        <dynamics>
          <damping>0.003</damping>
        </dynamics>
      </axis>
    </joint>
    <joint name="rl_roller03_joint" type="revolute">
      <pose relative_to="rl_roller03_link">0 0 0 0 0 0</pose>
      <parent>rl_wheel_link</parent>
      <child>rl_roller03_link</child>
      <axis>
        <xyz>0.707106781 0.707106781 -4.32978028e-17</xyz>
        <limit>
          <lower>-1e+16</lower>
          <upper>1e+16</upper>
          <effort>10</effort>
          <velocity>100</velocity>
        </limit>
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
      <child>rr_roller10_link</child>
      <axis>
        <xyz>-0.612372436 -0.707106781 -0.353553391</xyz>
        <limit>
          <lower>-1e+16</lower>
          <upper>1e+16</upper>
          <effort>10</effort>
          <velocity>100</velocity>
        </limit>
        <dynamics>
          <damping>0.003</damping>
        </dynamics>
      </axis>
    </joint>
    <joint name="rr_roller11_joint" type="revolute">
      <pose relative_to="rr_roller11_link">0 0 0 0 0 0</pose>
      <parent>rr_wheel_link</parent>
      <child>rr_roller11_link</child>
      <axis>
        <xyz>-0.353553391 -0.707106781 -0.612372436</xyz>
        <limit>
          <lower>-1e+16</lower>
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
