adibhudapratama/BARELANG/(commit log)

2026-10-19 Add CAD files
2026-10-20 Add CAD and cargo hold V6
    [Aircraft_Cargo_Hold.step, Bagasi_Pesawat_Generic_Cutaway.step, Bagasi_Pesawat_Generic_Full.step, Cargo_Lift_Robot.step, Robot_and_Cargo_Hold.step, Robot_and_Cargo_Hold_Cutaway.step, bag_template.sdf, base_link.stl]
2026-10-20 Revise repository structure and add new files
    Updated repository structure to include additional images and animations in the docs folder, and organized CAD files into subdirectories.
